tlbtlbtlb/scooter/sim/effgraph.png

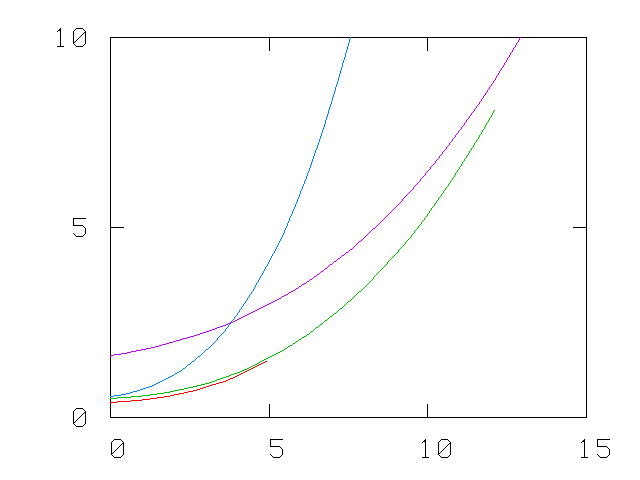
sim/effgraph.png
