tlbtlbtlb/scooter/sim/motor_torque_limits.png

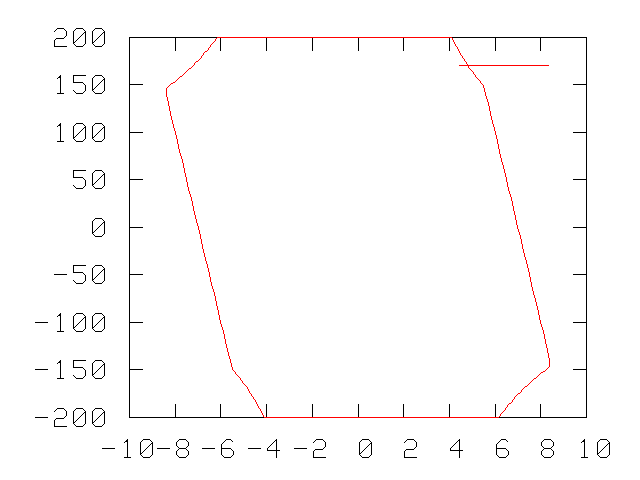
sim/motor_torque_limits.png
