tlbtlbtlb/scooter/sim/scooter-cartoon-frame.png

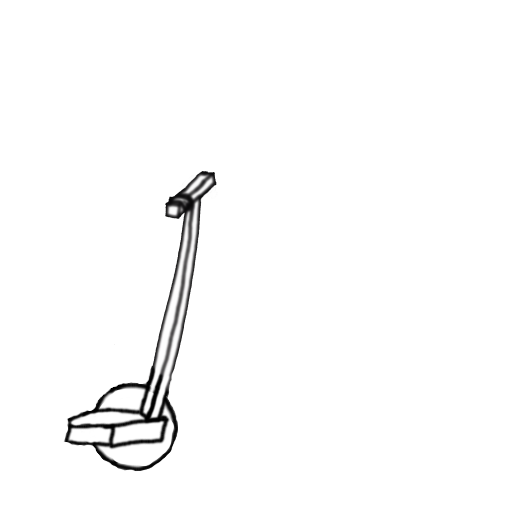
sim/scooter-cartoon-frame.png
