tlbtlbtlb/scooter/sim/scooter-cartoon-lowerarm.png

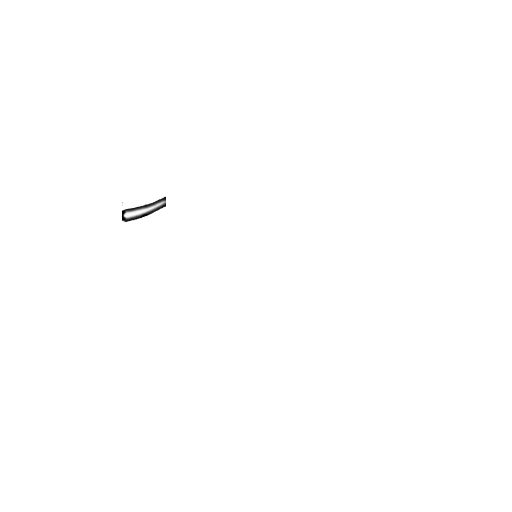
sim/scooter-cartoon-lowerarm.png
