tlbtlbtlb/scooter/sim/scooter-cartoon-ouch.png

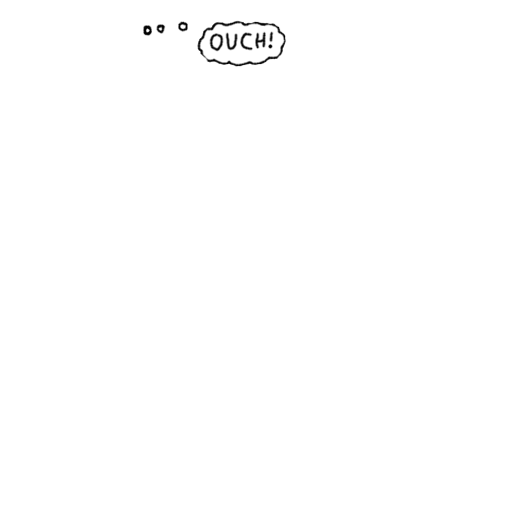
sim/scooter-cartoon-ouch.png
