tlbtlbtlb/scooter/sim/scooter-cartoon-rider.png

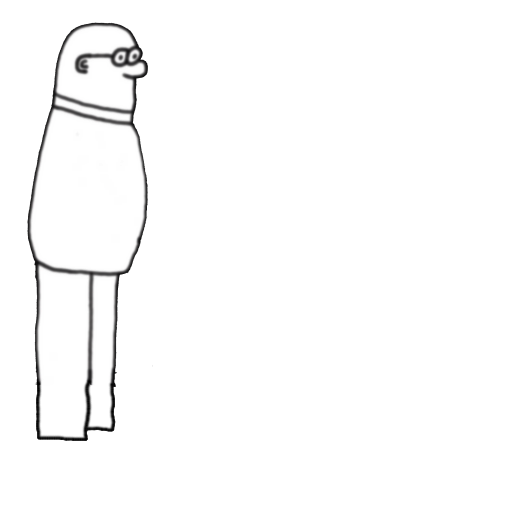
sim/scooter-cartoon-rider.png
