tlbtlbtlb/scooter/sim/scooter-cartoon-wheel.png

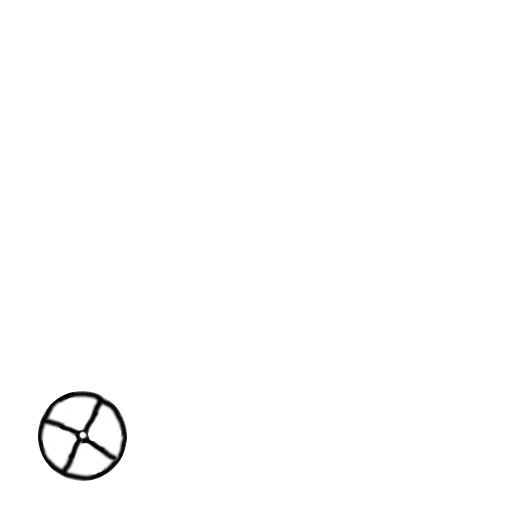
sim/scooter-cartoon-wheel.png
