tlbtlbtlb/scooter/sim/Slide1.png

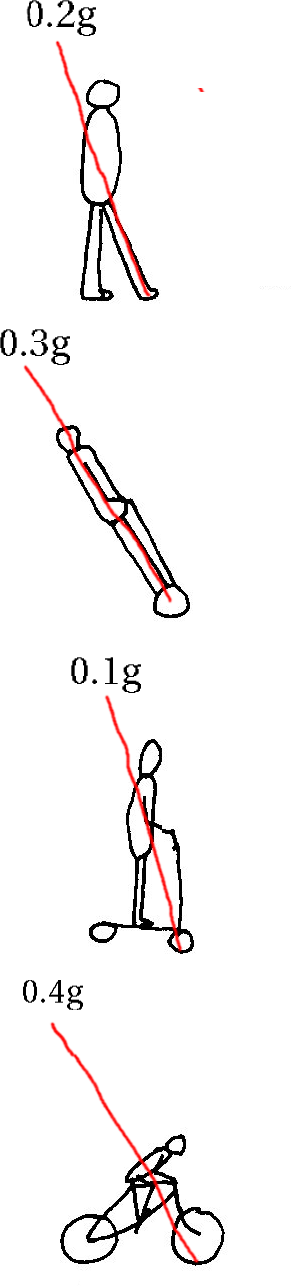
sim/Slide1.png
