tlbtlbtlb/scooter/sim/Slide2.png

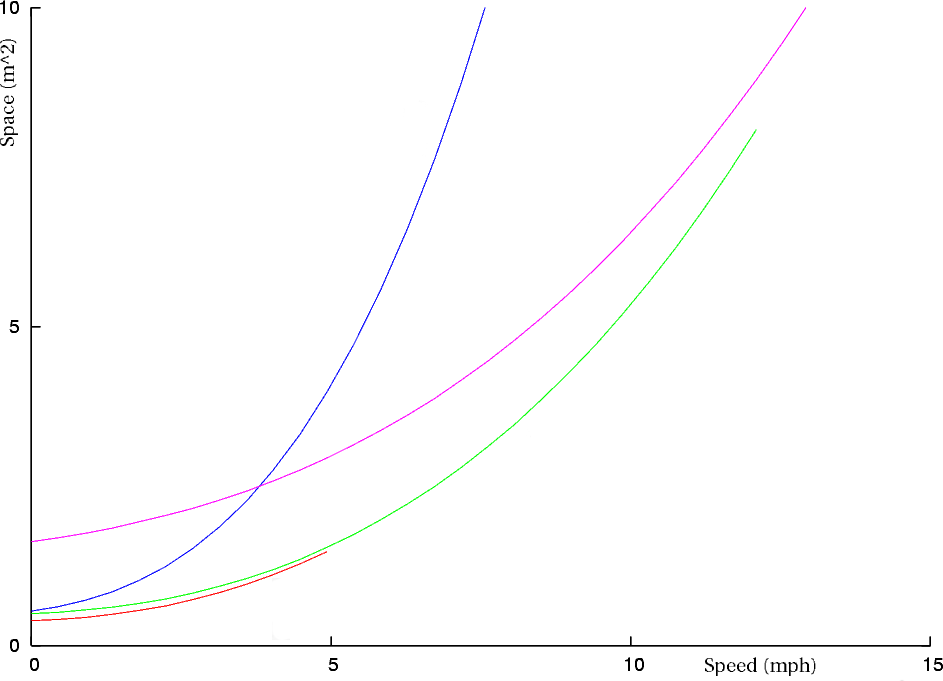
sim/Slide2.png
