tlbtlbtlb/scooter/sim/Slide3.png

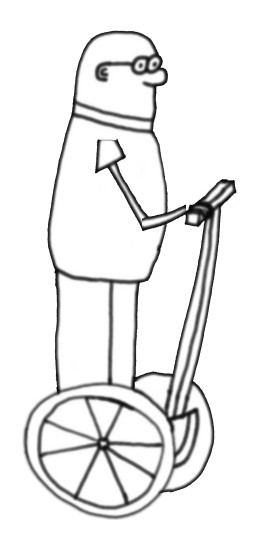
sim/Slide3.png
