tlbtlbtlb/scooter/sim/Slide5.png

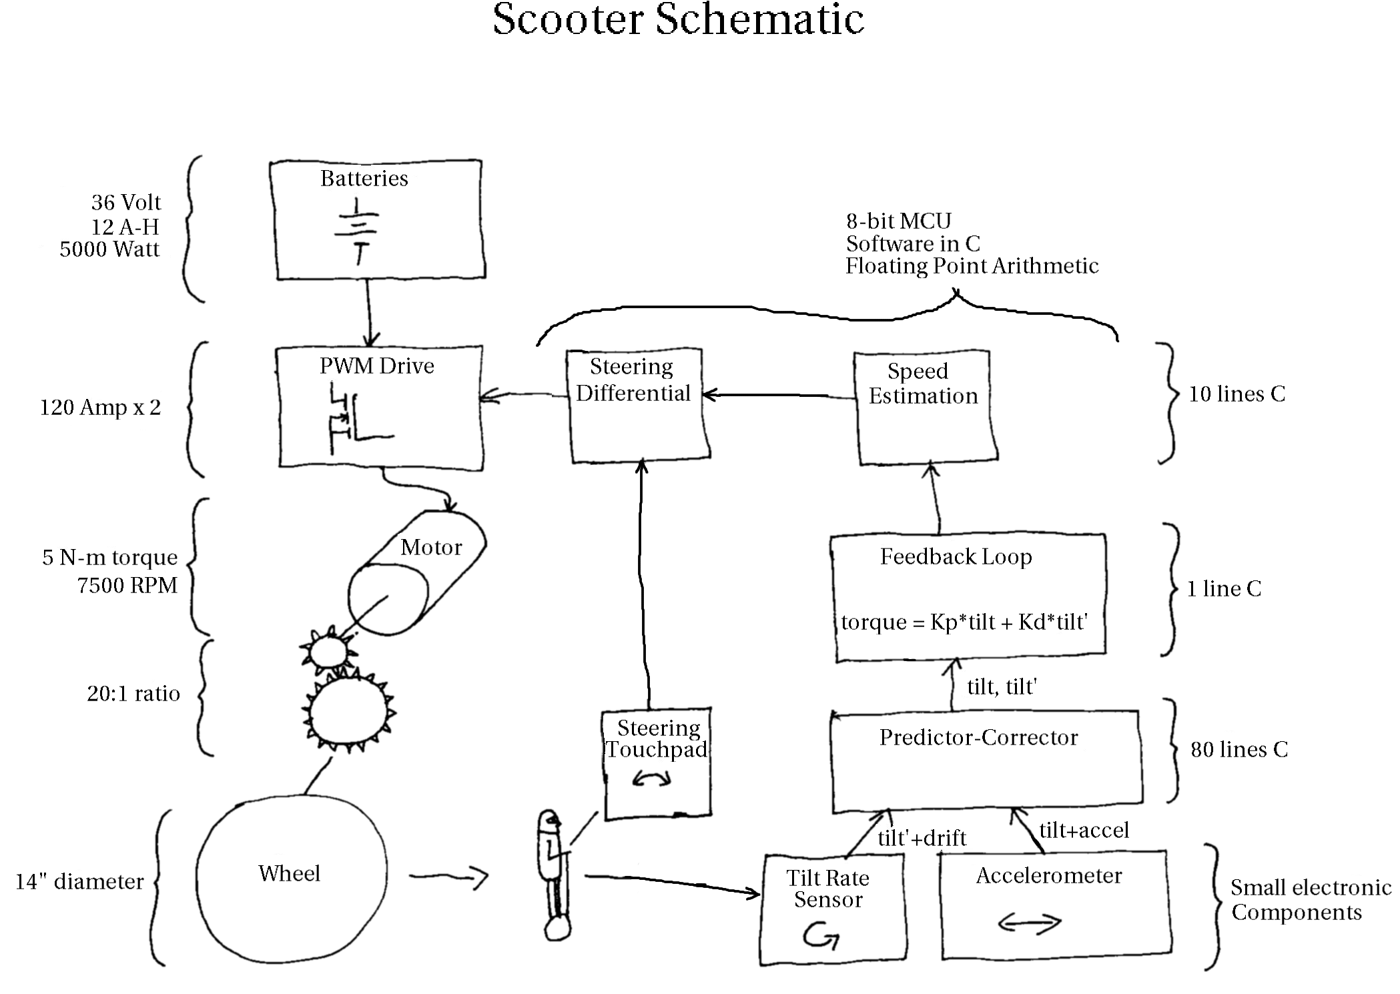
sim/Slide5.png
