tlbtlbtlb/scooter/sim/TopView.png

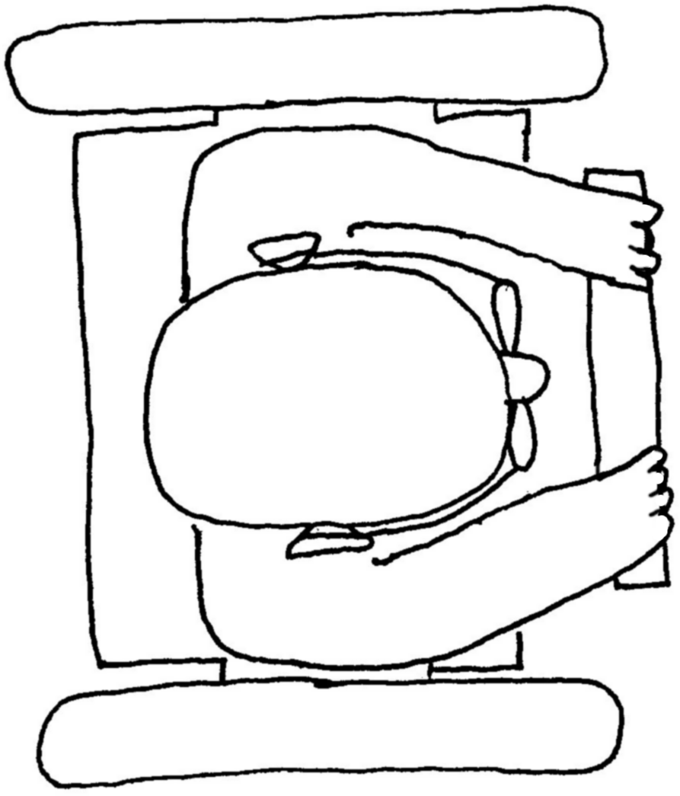
sim/TopView.png
