tlbtlbtlb/scooter/Unicycle/Mannequin.SLDASM

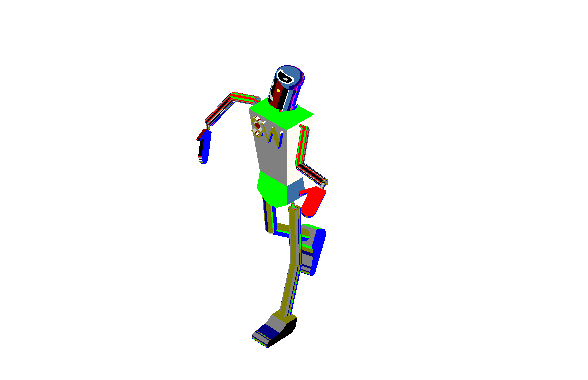
[picture p18: CAD file, 2012-12-04]
Unicycle/Mannequin.SLDASM
torso
head
arm x 4
leg x 4
foot x 2
hand x 2
