tlbtlbtlb/scooter/Unicycle/Unicycle.SLDASM

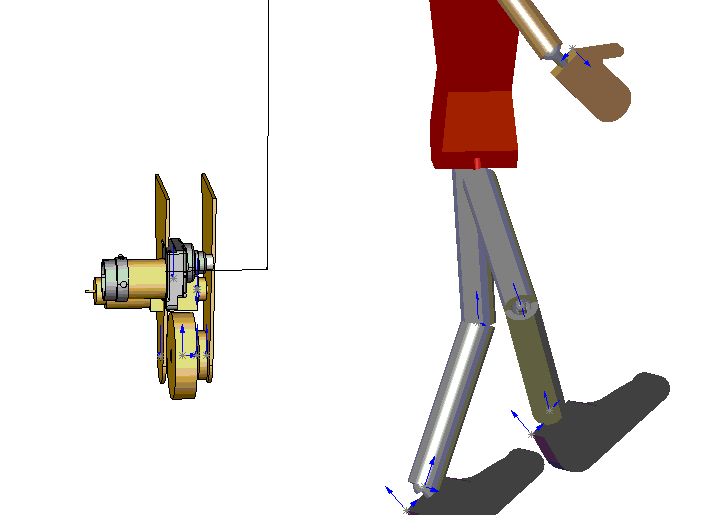
[picture p19: CAD file, 2012-12-04]
Unicycle/Unicycle.SLDASM
Right Side Plate
5mm HTD 15mm 72 teeth
Colson WC22
Left Side Plate
5mm HTD 15mm 34 teeth
S9134A-PG010SP
NPC_64038
torso
head
arm x 4
leg x 4
hand x 2
foot x 2
