tlbtlbtlb/scooter/Scooter Mechanical/Unicycle 2.SLDASM

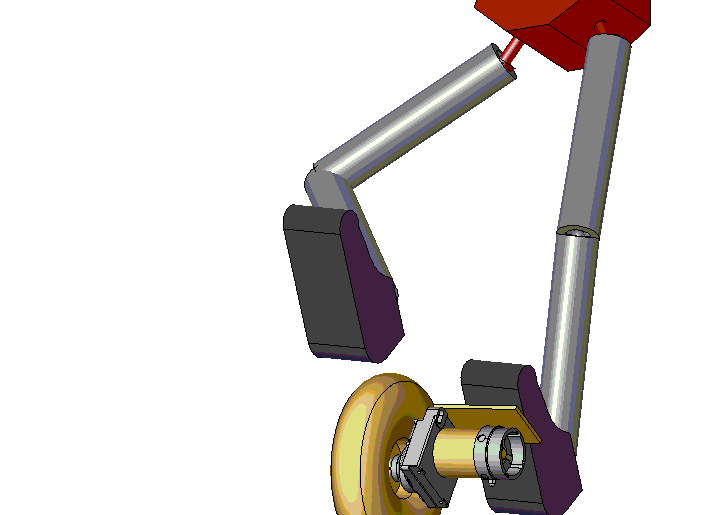
[picture p20: CAD file, 2012-12-04]
Scooter Mechanical/Unicycle 2.SLDASM
NPC_64038
NPC Wheel 14
torso
head
arm x 4
leg x 4
hand x 2
foot x 2
Top Plate
