tlbtlbtlb/scooter/Unicycle/Unicycle 7.SLDASM

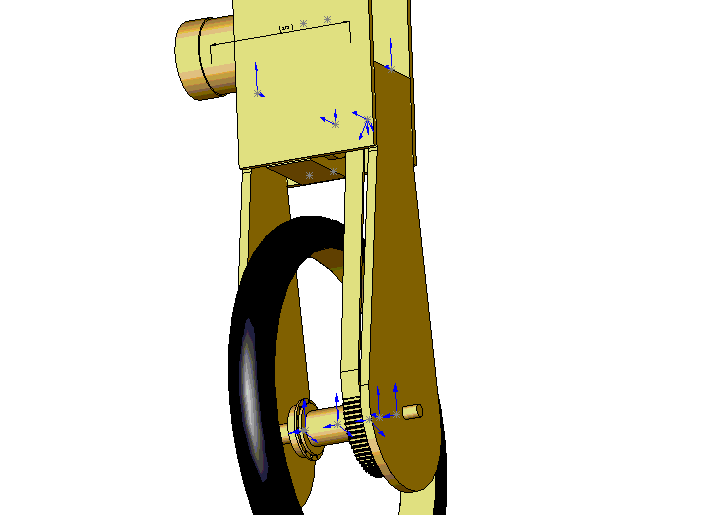
[picture p21: CAD file, 2012-12-04]
Unicycle/Unicycle 7.SLDASM
Front Plate
Side Bar x 2
Rear Plate
Belt Path
Instrument Ball Bearing_AI x 2
a_6a55_072nf1516_modified
Spoked Wheel Hub
Hub Axle
Hub Right Spacer 2
Hub Left Spacer 2
16 inch tire
Whyachi TWM3M
a_6a55_028df1516_modified
