tlbtlbtlb/scooter/Scooter Mechanical/Mannequin.SLDASM

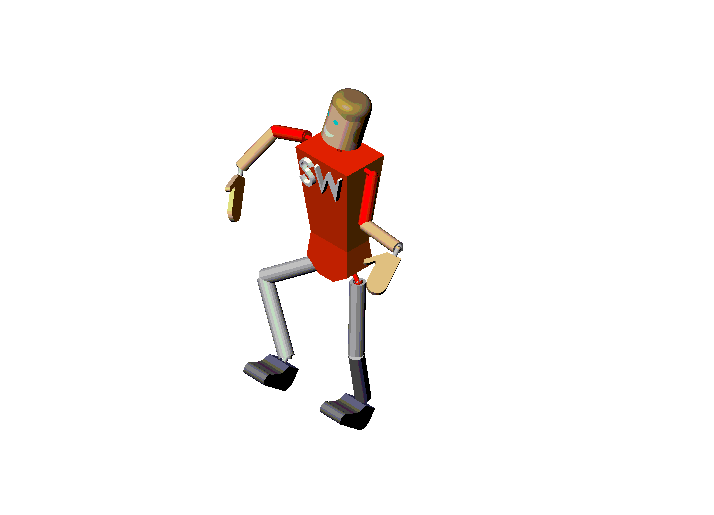
[picture p22: CAD file, 2012-12-04]
Scooter Mechanical/Mannequin.SLDASM
torso
head
arm x 4
leg x 4
hand x 2
foot x 2
