tlbtlbtlb/scooter/Unicycle/Unicycle 5.SLDASM

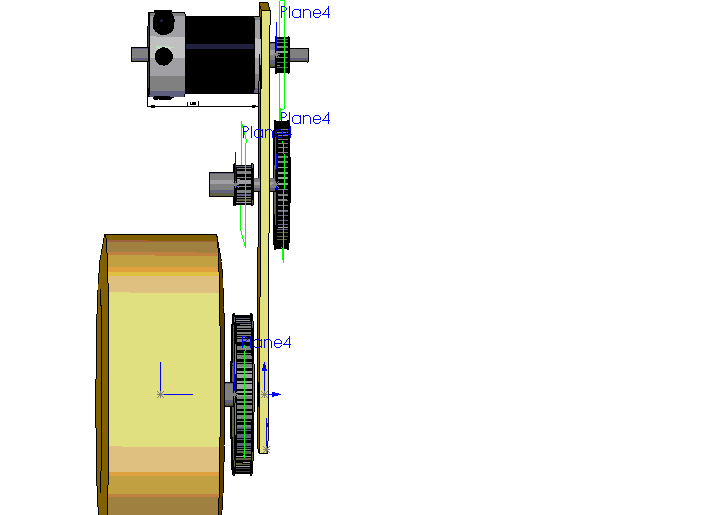
[picture p23: CAD file, 2012-12-04]
Unicycle/Unicycle 5.SLDASM
Timing Belt Pulley_AI x 4
Side Plate
Instrument Ball Bearing_AI
Magmotor S28-150
Go Kart Wheel
