tlbtlbtlb/scooter/Unicycle/Unicycle 3.SLDASM

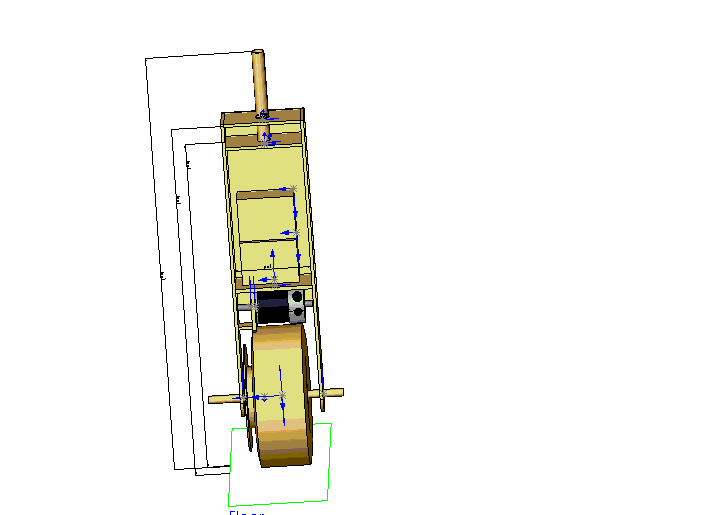
[picture p24: CAD file, 2012-12-04]
Unicycle/Unicycle 3.SLDASM
Go Kart Wheel
Wheel Shaft
Magmotor S28-150
Wheel Gear
Top Plate 2
Right Side Plate 2 x 2
Battlepack x 2
Motor Plate
Cover Plate
Top Plate 3 x 2
Seat Pipe
bead2
Motor Plate Brace
