tlbtlbtlb/scooter/Unicycle/Unicycle 4.SLDASM

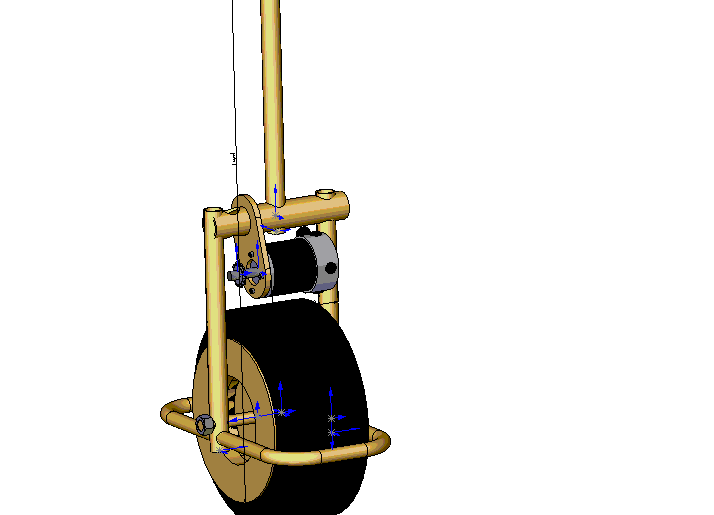
[picture p25: CAD file, 2012-12-04]
Unicycle/Unicycle 4.SLDASM
Go Kart Wheel
Wheel Gear
Magmotor S28-150
Side Pipe x 2
Wheel Shaft 2
Top Pipe
Motor Mount
Seat Pipe 2
Socket Head Cap Screw_AI x 4
Hex Nut_AI x 2
Hoop 2 x 2
Precision Roller Chain Sprocket_AI
