tlbtlbtlb/scooter/Unicycle/Electronics Box.SLDASM

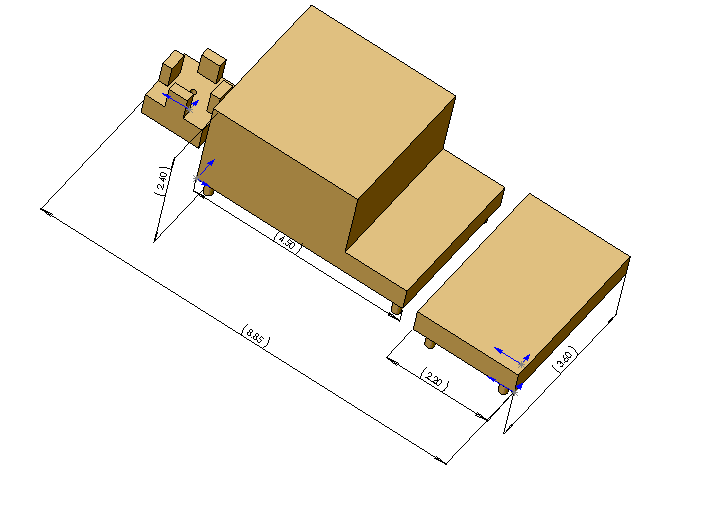
[picture p26: CAD file, 2012-12-04]
Unicycle/Electronics Box.SLDASM
Mavric II Outline
OSMC Outline
Bridge Rectifier Outline
