tlbtlbtlb/scooter/(list of files, cad)

Other CAD files:
Scooter Mechanical/Scooter.SLDASM
Scooter Mechanical/Skateboard.SLDASM
Scooter Mechanical/30 cell NiMH pack.sldasm
Scooter Mechanical/E7MS.SLDASM
Unicycle/Whyachi Motor and Pulley.SLDASM
Scooter Mechanical/Handlebars.SLDASM
Unicycle/Unicycle 6.SLDASM
Unicycle/Wheel and Pulley.sldasm
Scooter Mechanical/Motor Top Bar Left.SLDPRT
Unicycle/Top Plate.SLDPRT
Scooter Mechanical/NPC Wheel 14.SLDPRT
Scooter Mechanical/leg.SLDPRT
Scooter Mechanical/Dashboard.SLDPRT
Unicycle/Top Pipe.SLDPRT
Scooter Mechanical/Torque Sensor Mount.SLDPRT
Unicycle/Hub Axle.SLDPRT
Scooter Mechanical/6 cell NiMH pack.SLDPRT
Unicycle/Mavric II Outline.SLDPRT
Scooter Mechanical/Scooter Electronics Plate.SLDPRT
Unicycle/Yoke.SLDPRT
Scooter Mechanical/TRT-500.SLDPRT
Unicycle/Side Pipe 2.sldprt
Scooter Mechanical/Back Horiz Brace.SLDPRT
Unicycle/Wheel Gear.SLDPRT
Scooter Mechanical/Front Horiz Brace.SLDPRT
Unicycle/Hub Right Spacer 2.SLDPRT
Unicycle/Belt Guard.SLDPRT
Unicycle/arbeiter.sldprt
Scooter Mechanical/Bottom Plate.SLDPRT
Unicycle/a_6a55_028df1516_modified.SLDPRT
Scooter Mechanical/Battery Pack.SLDPRT
Unicycle/Hoop 2.SLDPRT
Unicycle/Colson WC22.SLDPRT
Scooter Mechanical/NPC 64038 Hub.SLDPRT
Unicycle/Front Plate 2.SLDPRT
Scooter Mechanical/Scooter Top Plate 2.SLDPRT
Unicycle/NPC PT-318.SLDPRT
Scooter Mechanical/Scooter Side Plate.SLDPRT
Unicycle/Magmotor S400.sldprt
Scooter Mechanical/Driver Heat Plate.SLDPRT
Unicycle/Go Kart Wheel.SLDPRT
Scooter Mechanical/Spoked Wheel Hub Large.SLDPRT
Unicycle/Spoked Wheel Hub.SLDPRT
Scooter Mechanical/arm.SLDPRT
Unicycle/Motor Mount.SLDPRT
Scooter Mechanical/Handle Top.SLDPRT
Unicycle/a_6a55_028df1516.SLDPRT
Scooter Mechanical/Scooter Handle Angle.SLDPRT
Unicycle/Side Bar.SLDPRT
Scooter Mechanical/TD132 Load Cell.SLDPRT
Unicycle/Top Pipe 2.SLDPRT
Scooter Mechanical/Bottom Plate 2.SLDPRT
Scooter Mechanical/Front Top Brace.SLDPRT
Unicycle/a_6a55_072nf1516.SLDPRT
Scooter Mechanical/Handlebar Grip.SLDPRT
Unicycle/Magmotor Bracket.SLDPRT
Scooter Mechanical/Scooter Bottom Bar Rear.SLDPRT
Unicycle/Seat Pipe 3.SLDPRT
Scooter Mechanical/Roboteq AX2500.SLDPRT
Unicycle/Front Plate.SLDPRT
Scooter Mechanical/SB Front Bottom Brace.SLDPRT
Unicycle/Hoop 1.SLDPRT
Unicycle/15 inch tire.SLDPRT
Scooter Mechanical/hand.SLDPRT
Unicycle/Footpeg.SLDPRT
Scooter Mechanical/Scooter Handle.SLDPRT
Unicycle/Whyachi Bracket.SLDPRT
Scooter Mechanical/Front Bottom Brace.SLDPRT
Unicycle/Bridge Rectifier Outline.SLDPRT
Scooter Mechanical/Scooter Motor Bottom Ext.SLDPRT
Unicycle/Browing 5ARA1-LR10.SLDPRT
Scooter Mechanical/Scooter Bottom Plate.SLDPRT
Unicycle/S9134A-PG010SP.SLDPRT
Scooter Mechanical/NPC_64038.SLDPRT
Unicycle/Cover Plate.SLDPRT
Scooter Mechanical/Scooter Top Plate.SLDPRT
Unicycle/16 inch tire.SLDPRT
Scooter Mechanical/SB Top Plate.SLDPRT
Unicycle/20 inch tire.SLDPRT
Scooter Mechanical/Handle Pipe.SLDPRT
Unicycle/Hub Right Spacer.SLDPRT
Scooter Mechanical/Skateboard Side Bar.SLDPRT
Scooter Mechanical/torso.SLDPRT
Unicycle/bead2.sldprt
Scooter Mechanical/foot.SLDPRT
Unicycle/leg.SLDPRT
Scooter Mechanical/Rear Edge Brace.SLDPRT
Scooter Mechanical/Rear Horiz Brace.SLDPRT
Unicycle/Side Axle Holder.SLDPRT
Scooter Mechanical/Front Edge Brace.SLDPRT
Unicycle/a_6a55_072nf1516_modified.SLDPRT
Scooter Mechanical/Top Structure.SLDPRT
Unicycle/Footrest.SLDPRT
Scooter Mechanical/Scooter Shroud 2.SLDPRT
Scooter Mechanical/head.SLDPRT
Unicycle/5mm HTD 15mm 34 teeth.SLDPRT
Scooter Mechanical/Side Plate.SLDPRT
Unicycle/Seat Pipe.SLDPRT
Scooter Mechanical/Scooter Bottom Bar Front.SLDPRT
Unicycle/foot.SLDPRT
Unicycle/Side Pipe.sldprt
Unicycle/Wheel Shaft.SLDPRT
Unicycle/Top Plate 3.SLDPRT
Unicycle/Unicycle Housing.SLDPRT
Unicycle/Right Side Plate.SLDPRT
Unicycle/Right Side Plate 2.SLDPRT
Unicycle/Rear Plate.SLDPRT
Unicycle/Battery Shelf.SLDPRT
Unicycle/Belt Path.SLDPRT
Unicycle/5mm HTD 15mm 72 teeth.SLDPRT
Unicycle/Left Side Plate.SLDPRT
Unicycle/Side Plate.SLDPRT
Unicycle/Motor Plate.SLDPRT
Unicycle/Part13.sldprt
Unicycle/head.SLDPRT
Unicycle/Hub Left Spacer.SLDPRT
Unicycle/Battlepack.SLDPRT
Unicycle/hand.SLDPRT
Unicycle/torso.SLDPRT
Unicycle/Motor Plate Brace.SLDPRT
Unicycle/Wheel Shaft 2.SLDPRT
Unicycle/Top Plate 2.SLDPRT
Unicycle/arm.SLDPRT
Unicycle/Magmotor S28-150.sldprt
Unicycle/Axle Holder and Footrest.SLDPRT
Unicycle/Whyachi TWM3M.SLDPRT
Unicycle/Hub Left Spacer 2.SLDPRT
Unicycle/Seat Pipe 2.SLDPRT
Unicycle/bead1.sldprt
Unicycle/OSMC Outline.SLDPRT
Scooter Mechanical/Electronics Drawings.SLDDRW
Scooter Mechanical/Handlebars.SLDDRW
Scooter Mechanical/Scooter Drawings.SLDDRW
Scooter Mechanical/Skateboard Fab.SLDDRW
Unicycle/Unicycle 4.SLDDRW
Unicycle/Unicycle 6.SLDDRW
Unicycle/Unicycle.SLDDRW
Unicycle/Whyachi Bolt Plate 2.SLDPRT
Unicycle/Whyachi Bolt Plate.SLDPRT
Unicycle/a_6a55_028df1516.igs
Unicycle/a_6a55_072nf1516.igs
