tlbtlbtlb/scooter/Scooter Drawings.pdf

# Trevor Blac kwell tlb@tlb.org

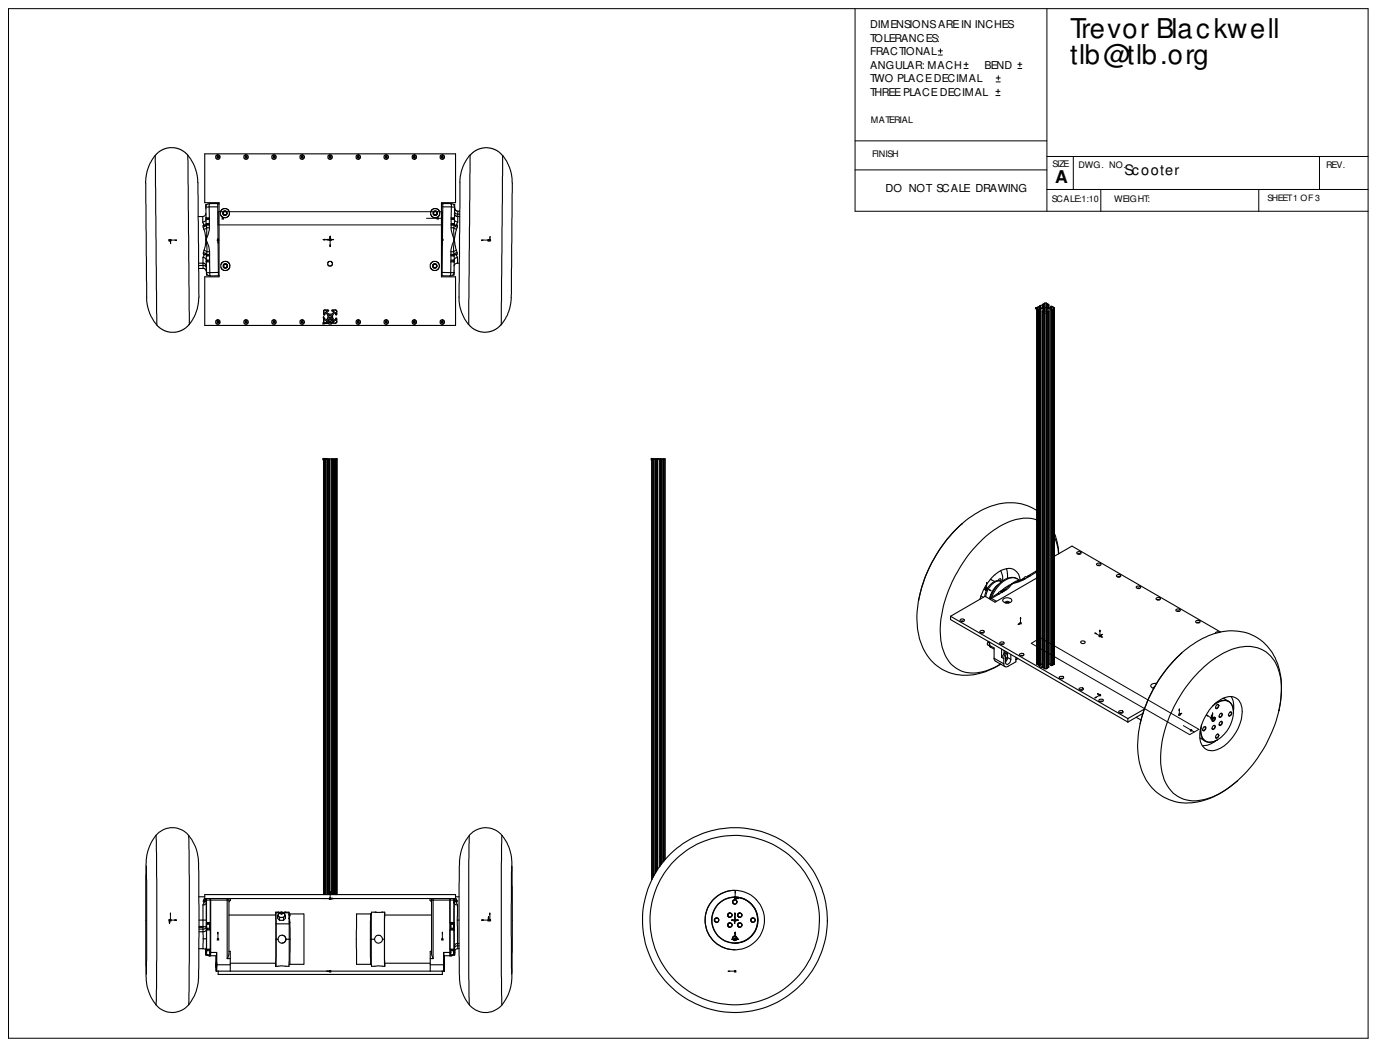
[picture p27: page 1]
MATERIAL; FINISH; ANGULAR: MACH; BEND

DIMENSIONSAREIN INCHES
TOLERANCES:
FRACTIONAL
TWO PLACE DECIMAL
THREEPLACE DECIMAL

SIZE A | DWG. NO. Sc ooter | REV.

DO NOT SCALE DRAWING

SCALE:1:10 | WEIGHT: | SHEET1 OF 3

0.656 X 82°

# 4 Holes

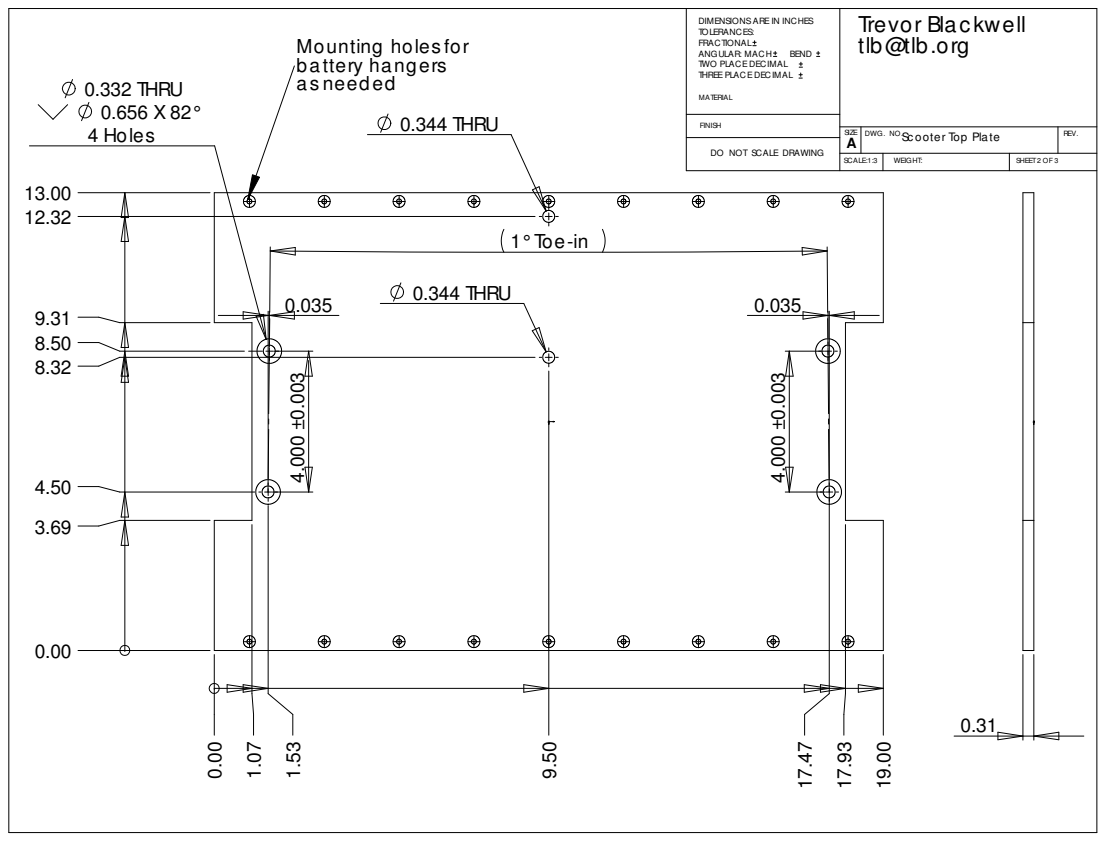
[picture p28: page 2]
0.332 THRU; 0.344 THRU; 0.344 THRU 0.035; 1°Toe-in; MATERIAL; FINISH; ANGULAR: MACH; BEND

Mounting holes for
battery hangers
a s needed

tlb@tlb.org

TWO PLACE DECIMAL
THREEPLACE DECIMAL

SIZE A | DWG. NO. Sc ooter Top Plate | REV.

DO NOT SCALE DRAWING

SCALE:1:3 | WEIGHT: | SHEET2 OF 3

# tlb@tlb.org

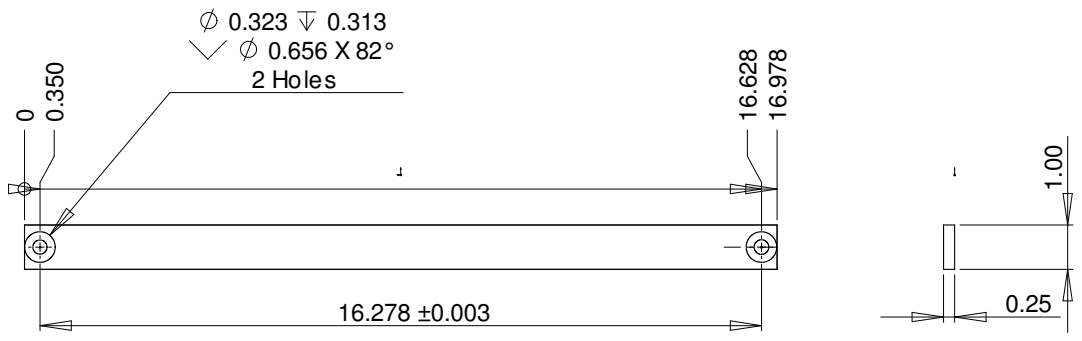
[picture p29: page 3]
0.656 X 82° 2 Holes; MATERIAL; FINISH; ANGULAR: MACH; BEND

TWO PLACE DECIMAL
THREEPLACE DECIMAL

SIZE A | DWG. NO. Sc ooter Bottom Bar Rear | REV.

DO NOT SCALE DRAWING

SCALE:1:3 | WEIGHT: | SHEET3 OF 3
