tlbtlbtlb/scooter/doc/pcb_all.pdf

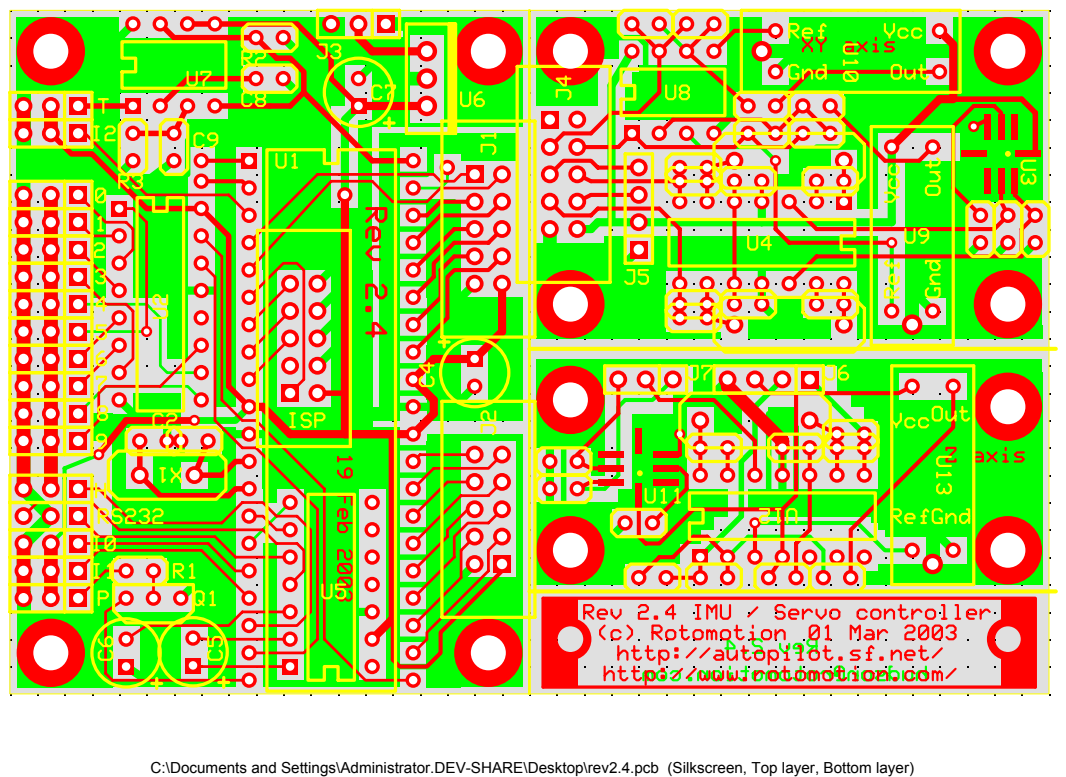
[picture p30: page 1]

C:\Documents and Settings\Administrator.DEV-SHARE\Desktop\rev2.4.pcb (Silkscreen, Top layer, Bottom layer)
