tlbtlbtlb/scooter/autopilot/onboard-release/pcb/rev2.pdf

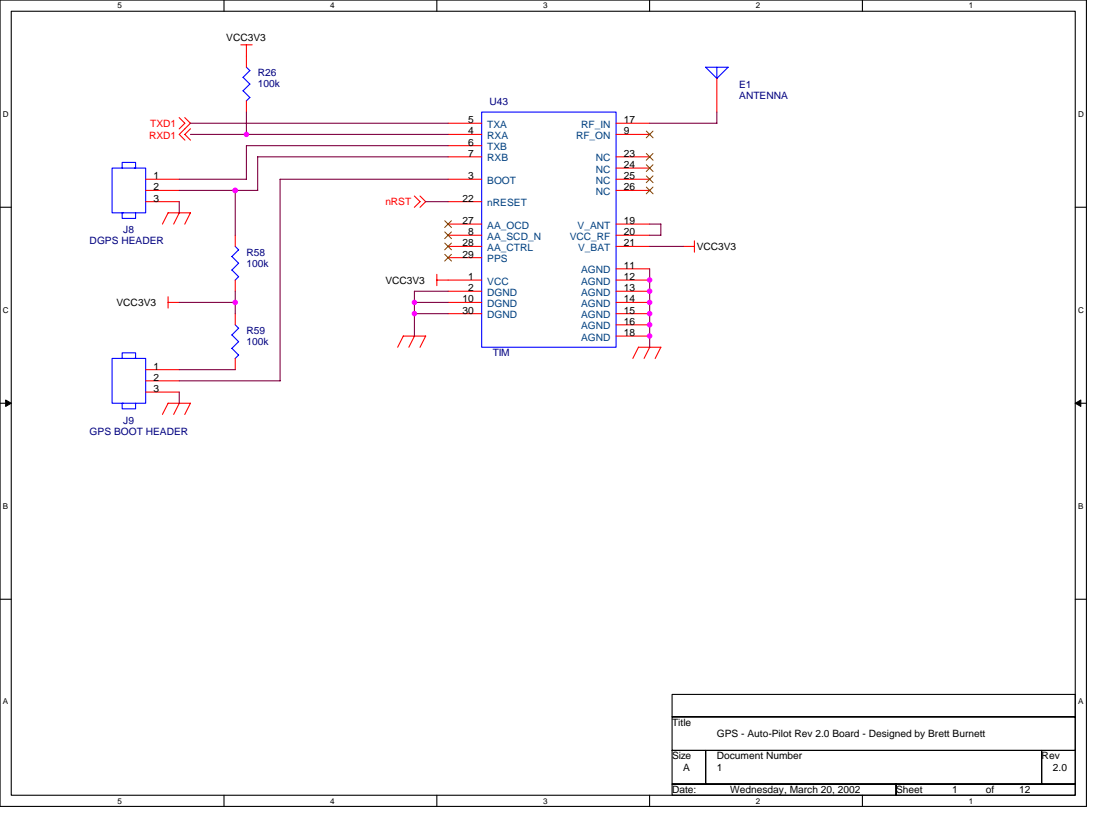
[picture p31: page 1]
Title; nRST; TXD1 RXD1; VCC3V3; TIM; TXA RXA TXB RXB; BOOT; nRESET; AA_OCD AA_SCD_N AA_CTRL PPS; VCC; V_ANT; V_BAT; VCC_RF; DGND DGND; AGND AGND AGND AGND AGND AGND AGND; DGND; ANTENNA; J8 DGPS HEADER

GPS BOOT HEADER

GPS - Auto-Pilot Rev 2.0 Board - Designed by Brett Burnett

Size A | Document Number 1 | Rev 2.0

Date: Wednesday, March 20, 2002 | Sheet 1 of 12

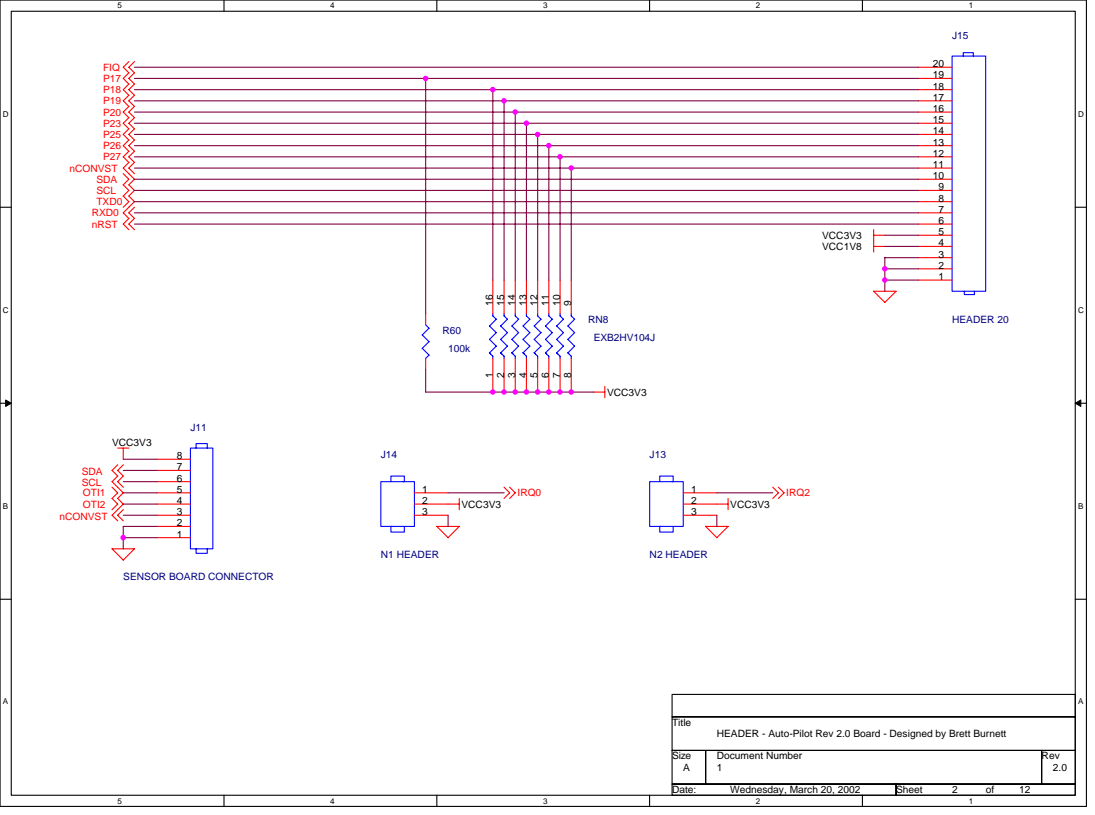
[picture p32: page 2]

HEADER - Auto-Pilot Rev 2.0 Board - Designed by Brett Burnett

Size A | Document Number 1 | Rev 2.0

Wednesday, March 20, 2002 | 2 12

# JTAG - 20 Pin ARM Connector

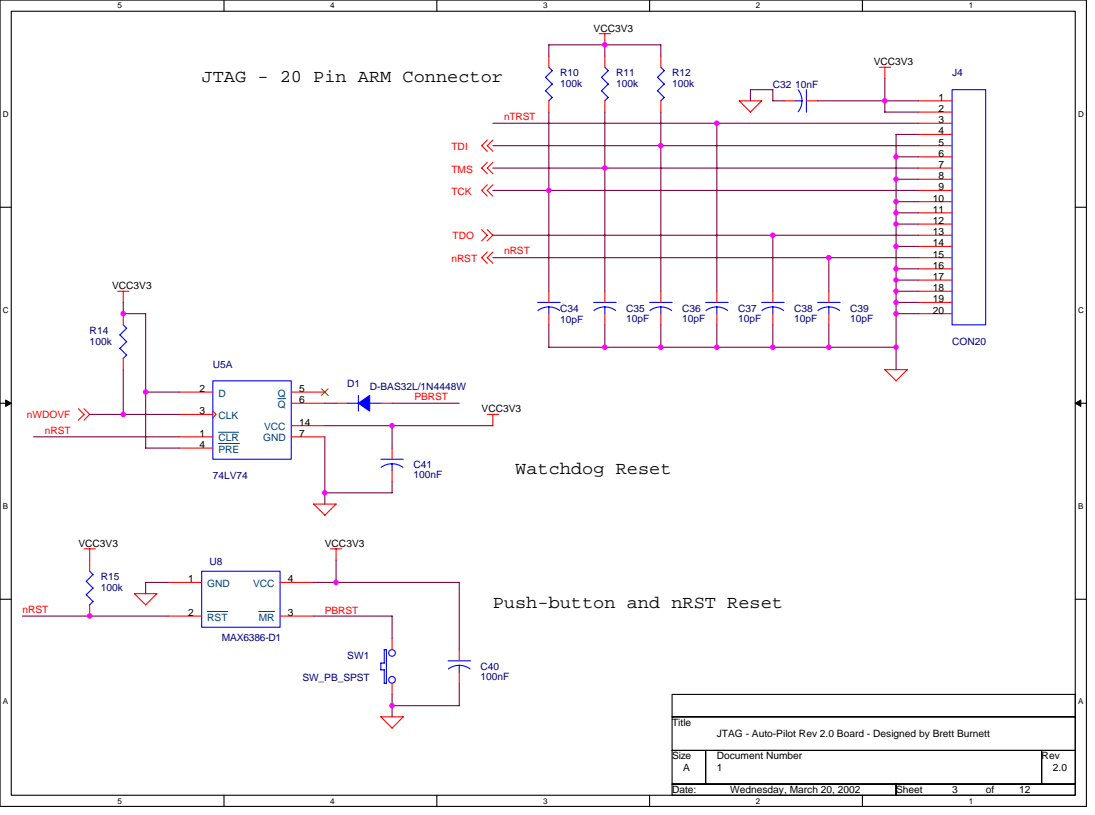
[picture p33: page 3]

Push-button and nRST Reset

JTAG - Auto-Pilot Rev 2.0 Board - Designed by Brett Burnett

Size A | Document Number 1 | Rev 2.0

Wednesday, March 20, 2002 | 3 12

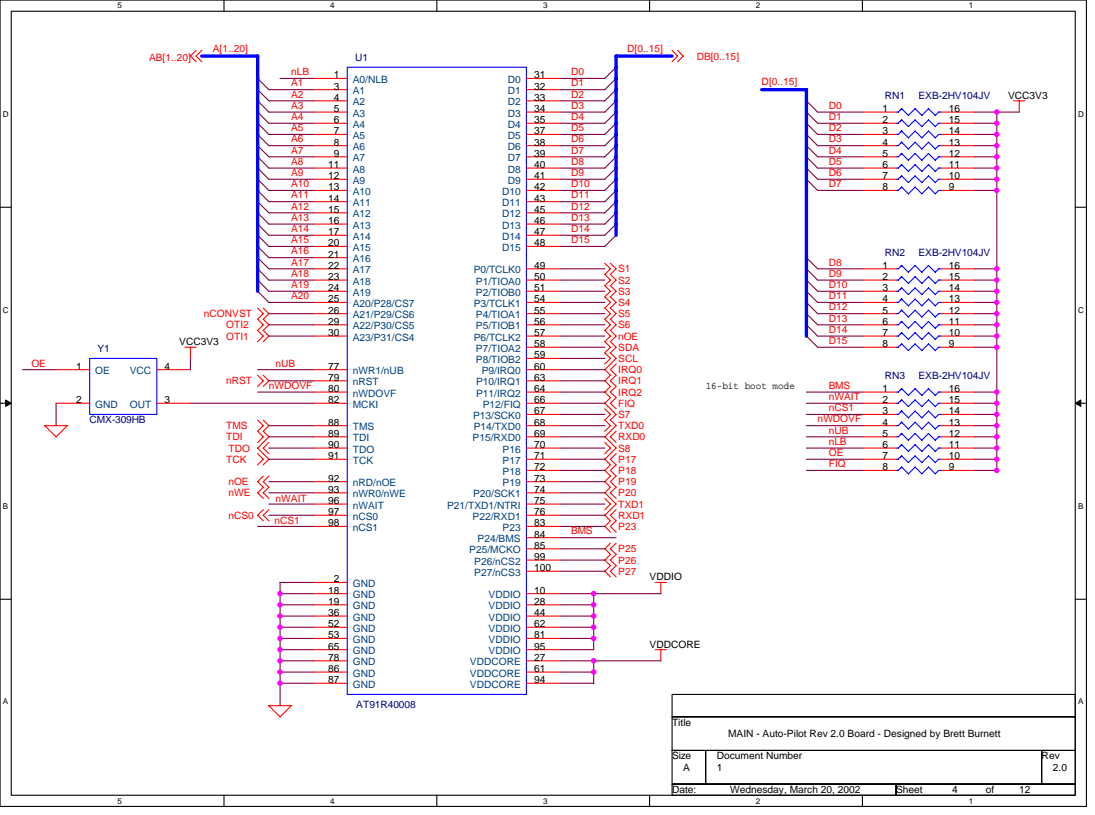
[picture p34: page 4]

MAIN - Auto-Pilot Rev 2.0 Board - Designed by Brett Burnett

Size A | Document Number 1 | Rev 2.0

Wednesday, March 20, 2002 | 4 12

# 512K I2C EEPROM

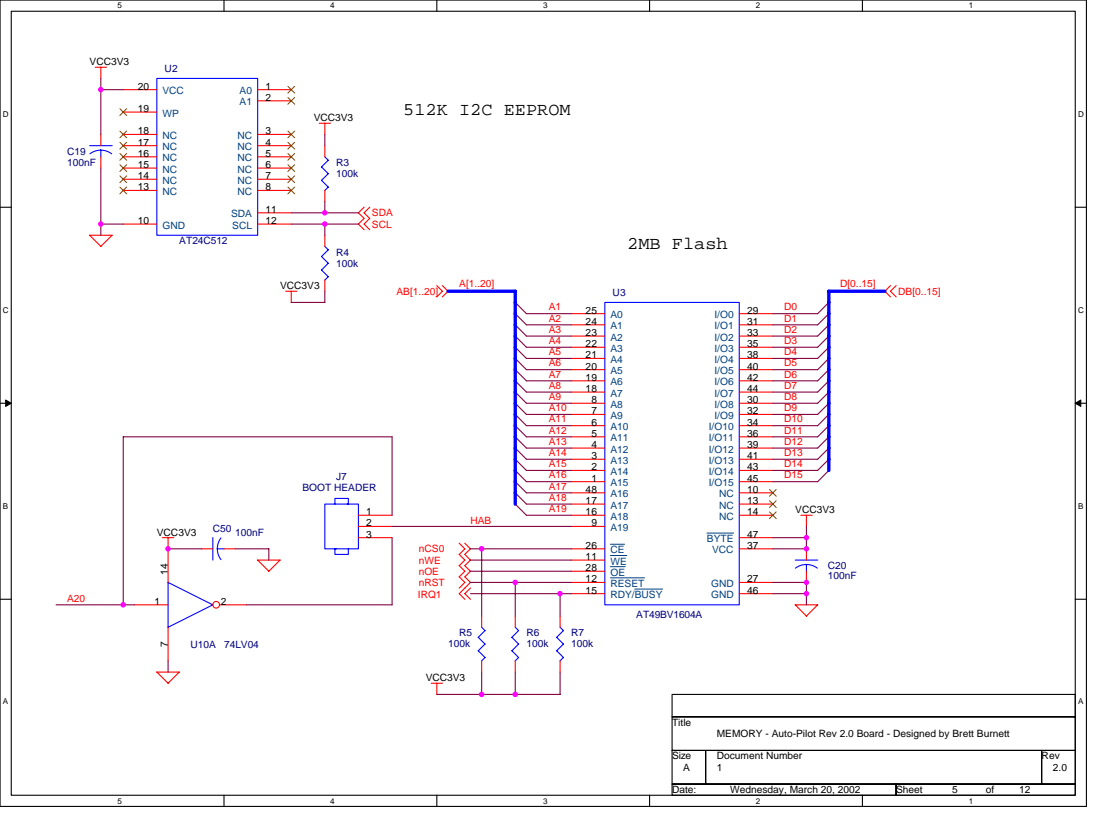
[picture p35: page 5]

MEMORY - Auto-Pilot Rev 2.0 Board - Designed by Brett Burnett

Size A | Document Number 1 | Rev 2.0

Wednesday, March 20, 2002 | 5 12

# Lithium Battery Charger

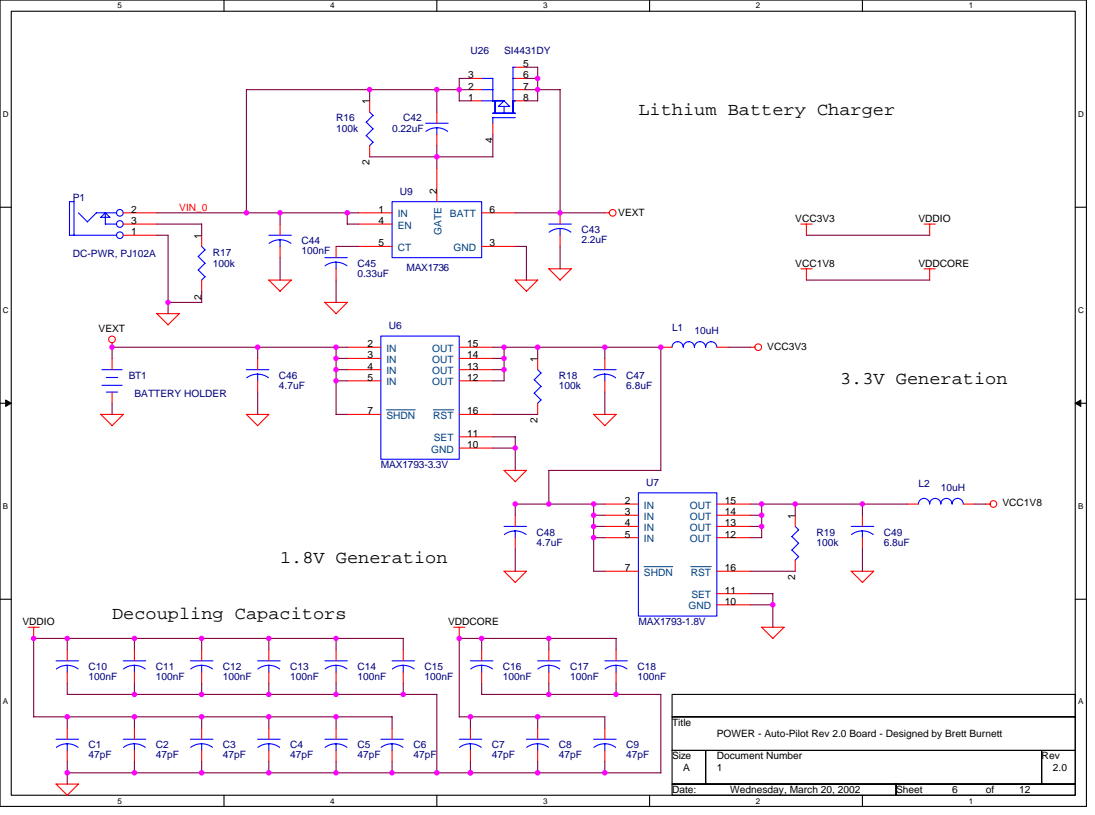
[picture p36: page 6]

POWER - Auto-Pilot Rev 2.0 Board - Designed by Brett Burnett

Size A | Document Number 1 | Rev 2.0

Wednesday, March 20, 2002 | 6 12

# UART RS-232 level Converter and Headers

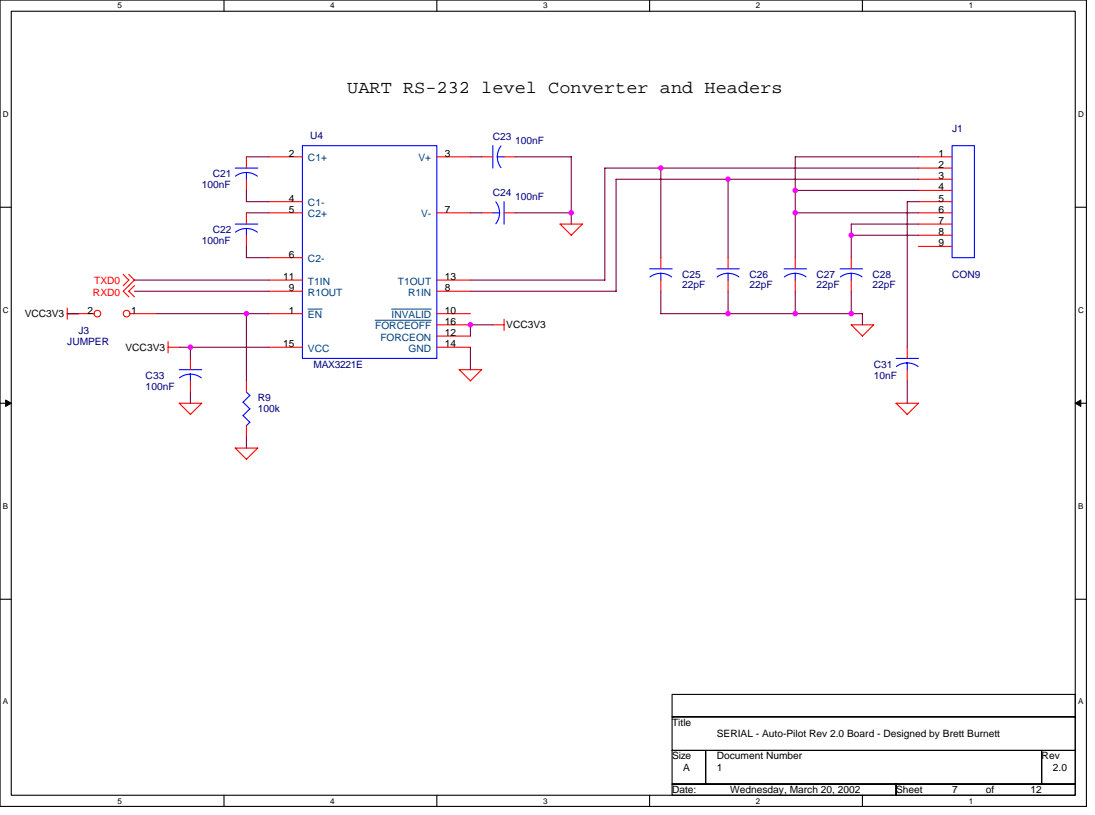
[picture p37: page 7]

SERIAL - Auto-Pilot Rev 2.0 Board - Designed by Brett Burnett

Size A | Document Number 1 | Rev 2.0

Wednesday, March 20, 2002 | 7 12

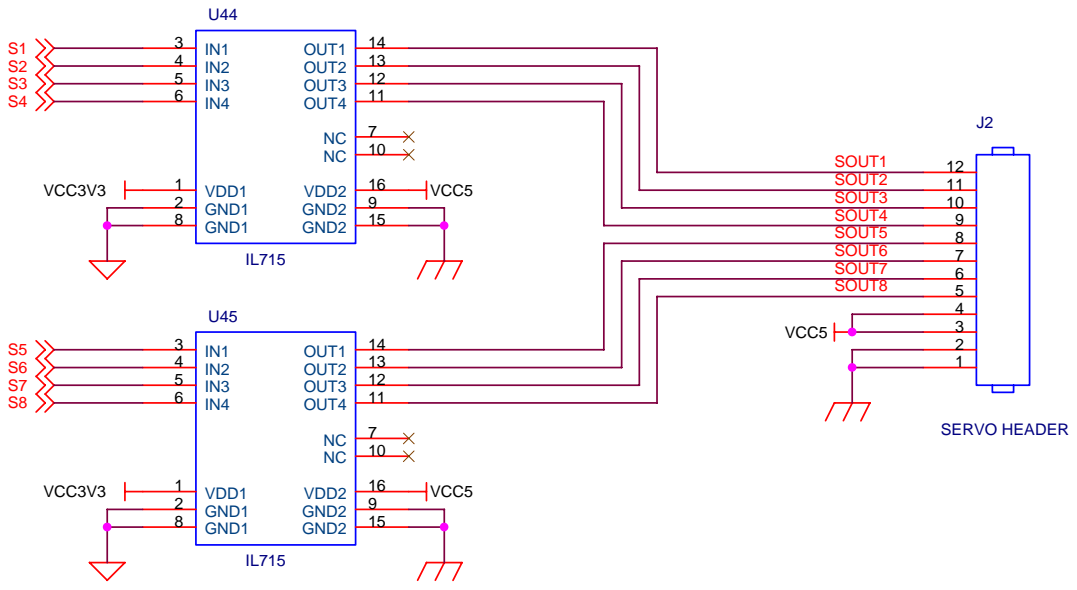
[picture p38: page 8]
Title; SOUT2; SOUT4; SOUT8; SOUT7; SOUT1; SOUT3; SOUT5 SOUT6; VCC5; VCC3V3; VDD1 GND1 GND1; VDD2 GND2 GND2; OUT1 OUT2 OUT3 OUT4; SERVO HEADER

SERVOS - Auto-Pilot Rev 2.0 Board - Designed by Brett Burnett

Size A | Document Number 1 | Rev 2.0

Wednesday, March 20, 2002 | 8 12

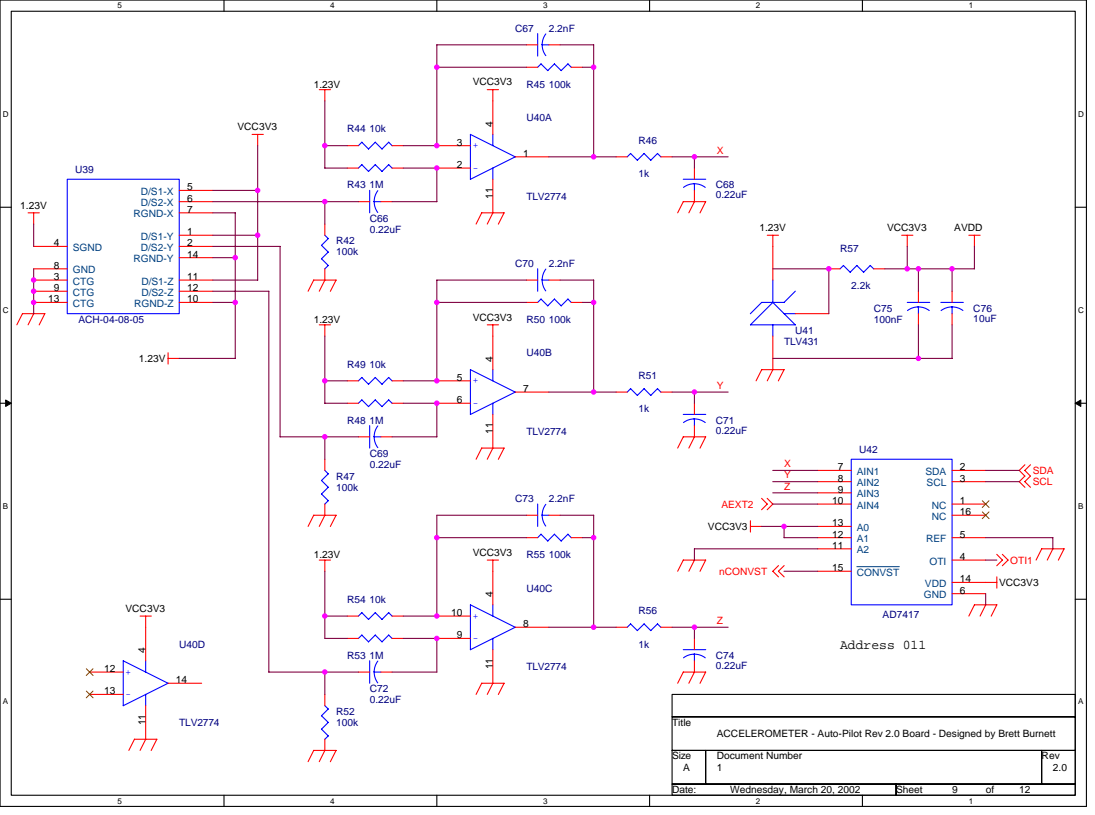
[picture p39: page 9]

ACCELEROMETER - Auto-Pilot Rev 2.0 Board - Designed by Brett Burnett

Size A | Document Number 1 | Rev 2.0

Wednesday, March 20, 2002 | 9 12

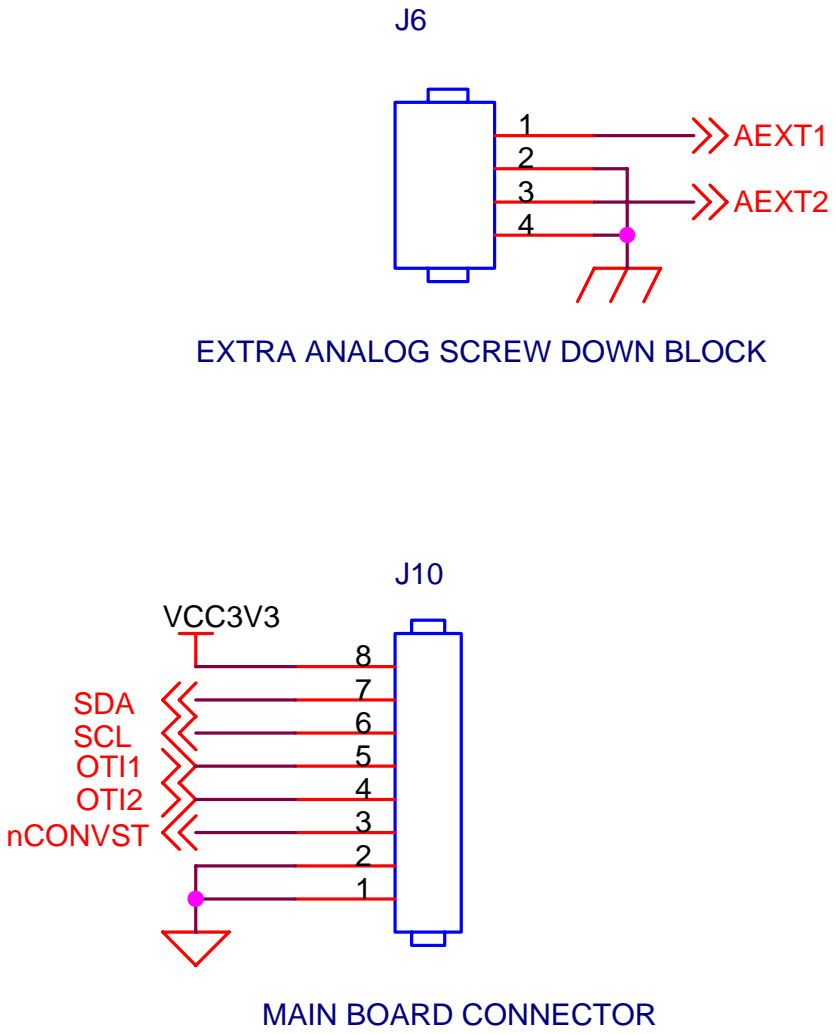
[picture p40: page 10]
SDA SCL OTI1 OTI2 nCONVST; AEXT2; AEXT1; VCC3V3

EXTRA ANALOG SCREW DOWN BLOCK

MAIN BOARD CONNECTOR

Title
DAUGHTER HEADERS - Auto-Pilot Rev 2.0 Board - Designed by Brett Burnett

Size A | Document Number 1 | Rev 2.0

Wednesday, March 20, 2002 | 10 12

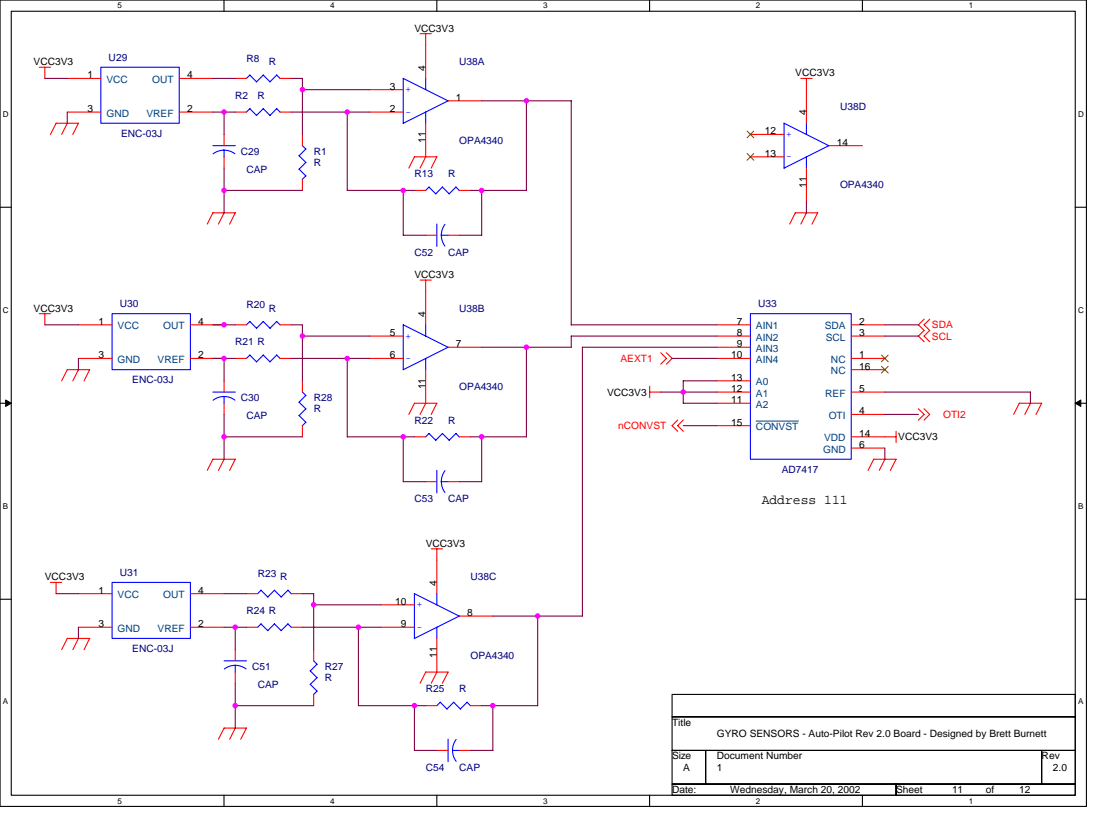
[picture p41: page 11]

GYRO SENSORS - Auto-Pilot Rev 2.0 Board - Designed by Brett Burnett

Size A | Document Number 1 | Rev 2.0

Wednesday, March 20, 2002 | 11 12

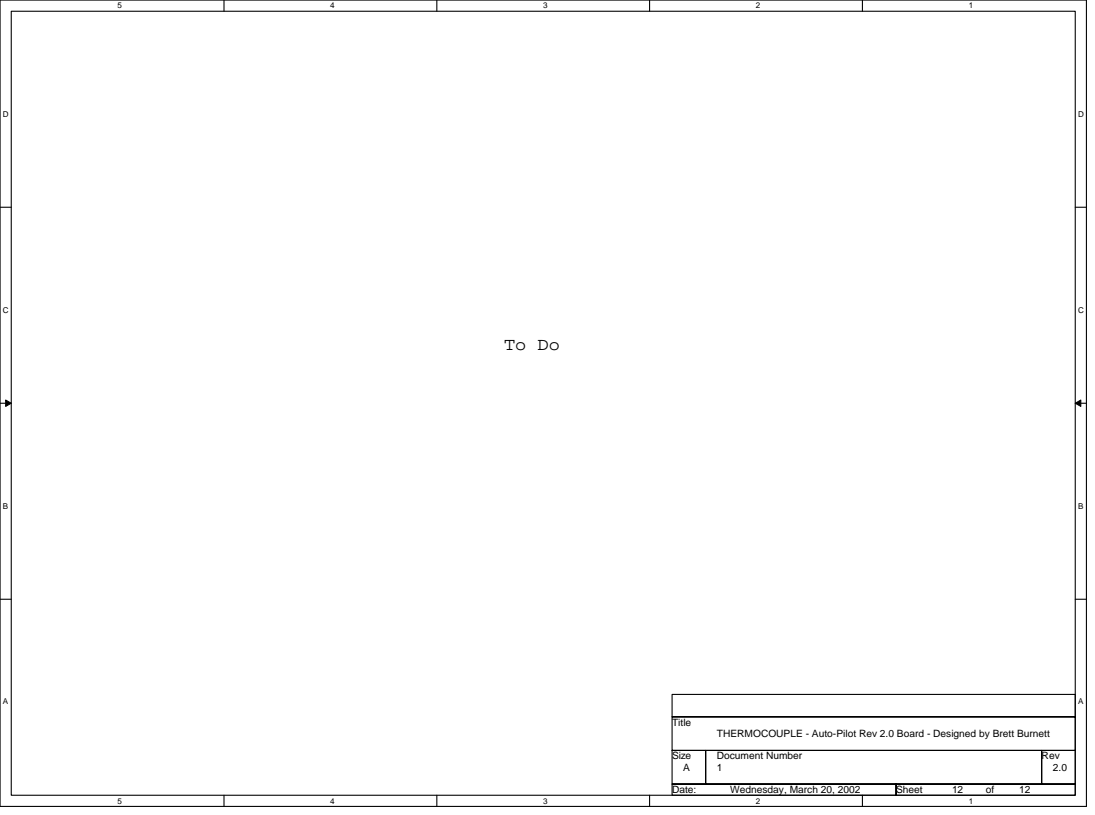
[picture p42: page 12]
Title

THERMOCOUPLE - Auto-Pilot Rev 2.0 Board - Designed by Brett Burnett

Size A | Document Number 1 | Rev 2.0

Wednesday, March 20, 2002 | 12 12
