tlbtlbtlb/scooter/electronics/controller6/stuffdraw.pdf

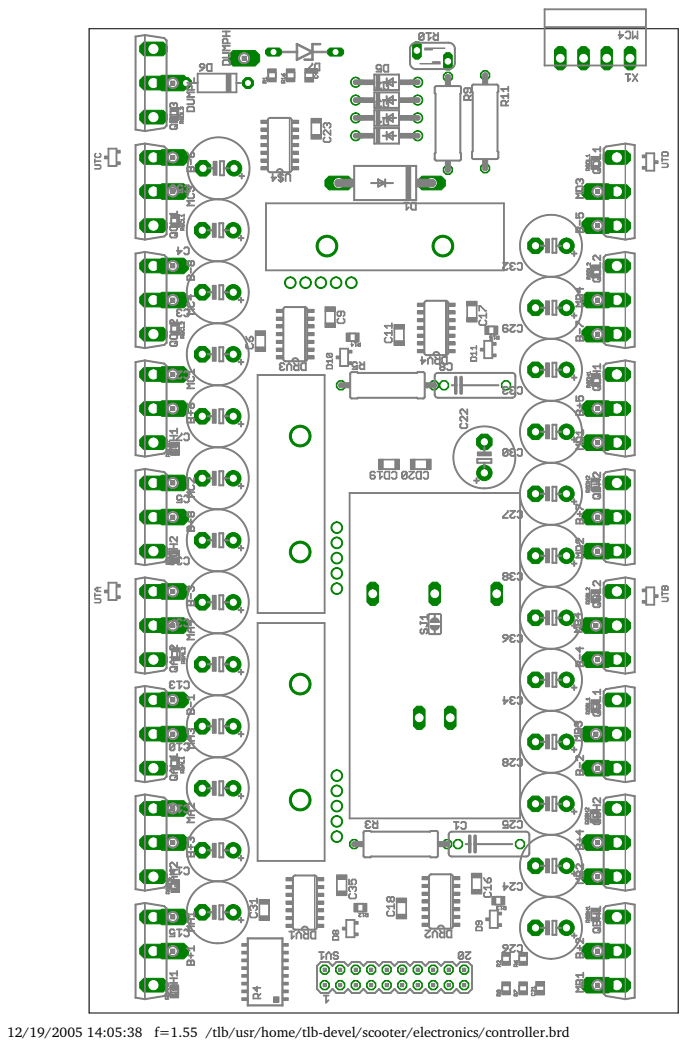
[picture p43: page 1]

12/19/2005 14:05:38 f=1.55 /tlb/usr/home/tlb-devel/scooter/electronics/controller.brd

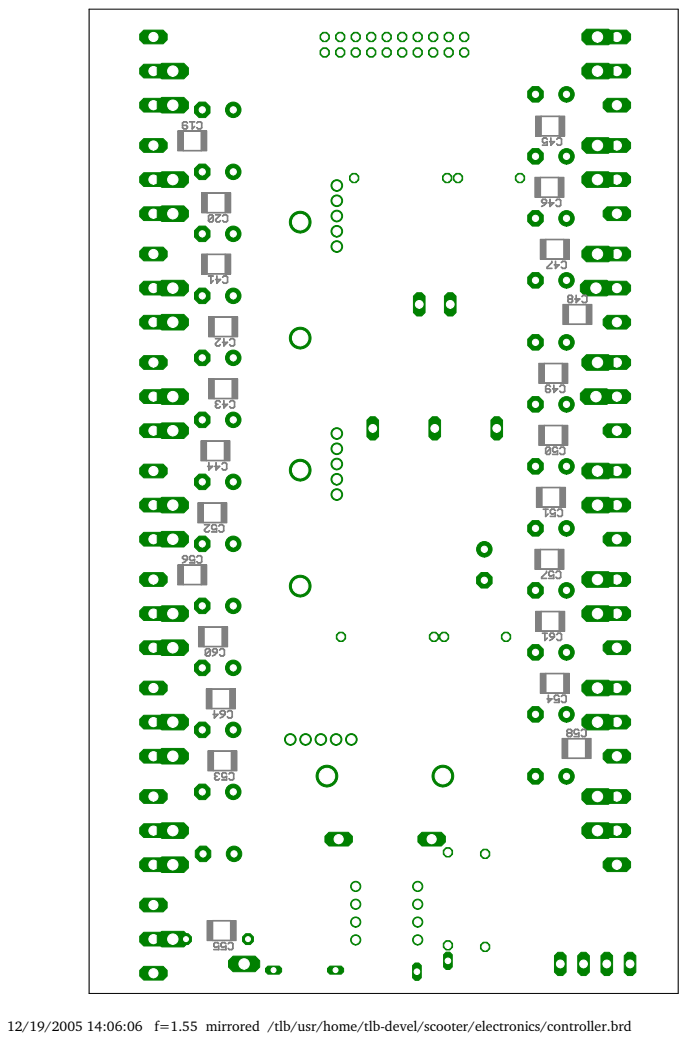
[picture p44: page 2]

12/19/2005 14:06:06 f=1.55 mirrored /tlb/usr/home/tlb-devel/scooter/electronics/controller.brd
