tlbtlbtlb/scooter/electronics/controller6/wiring.pdf

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

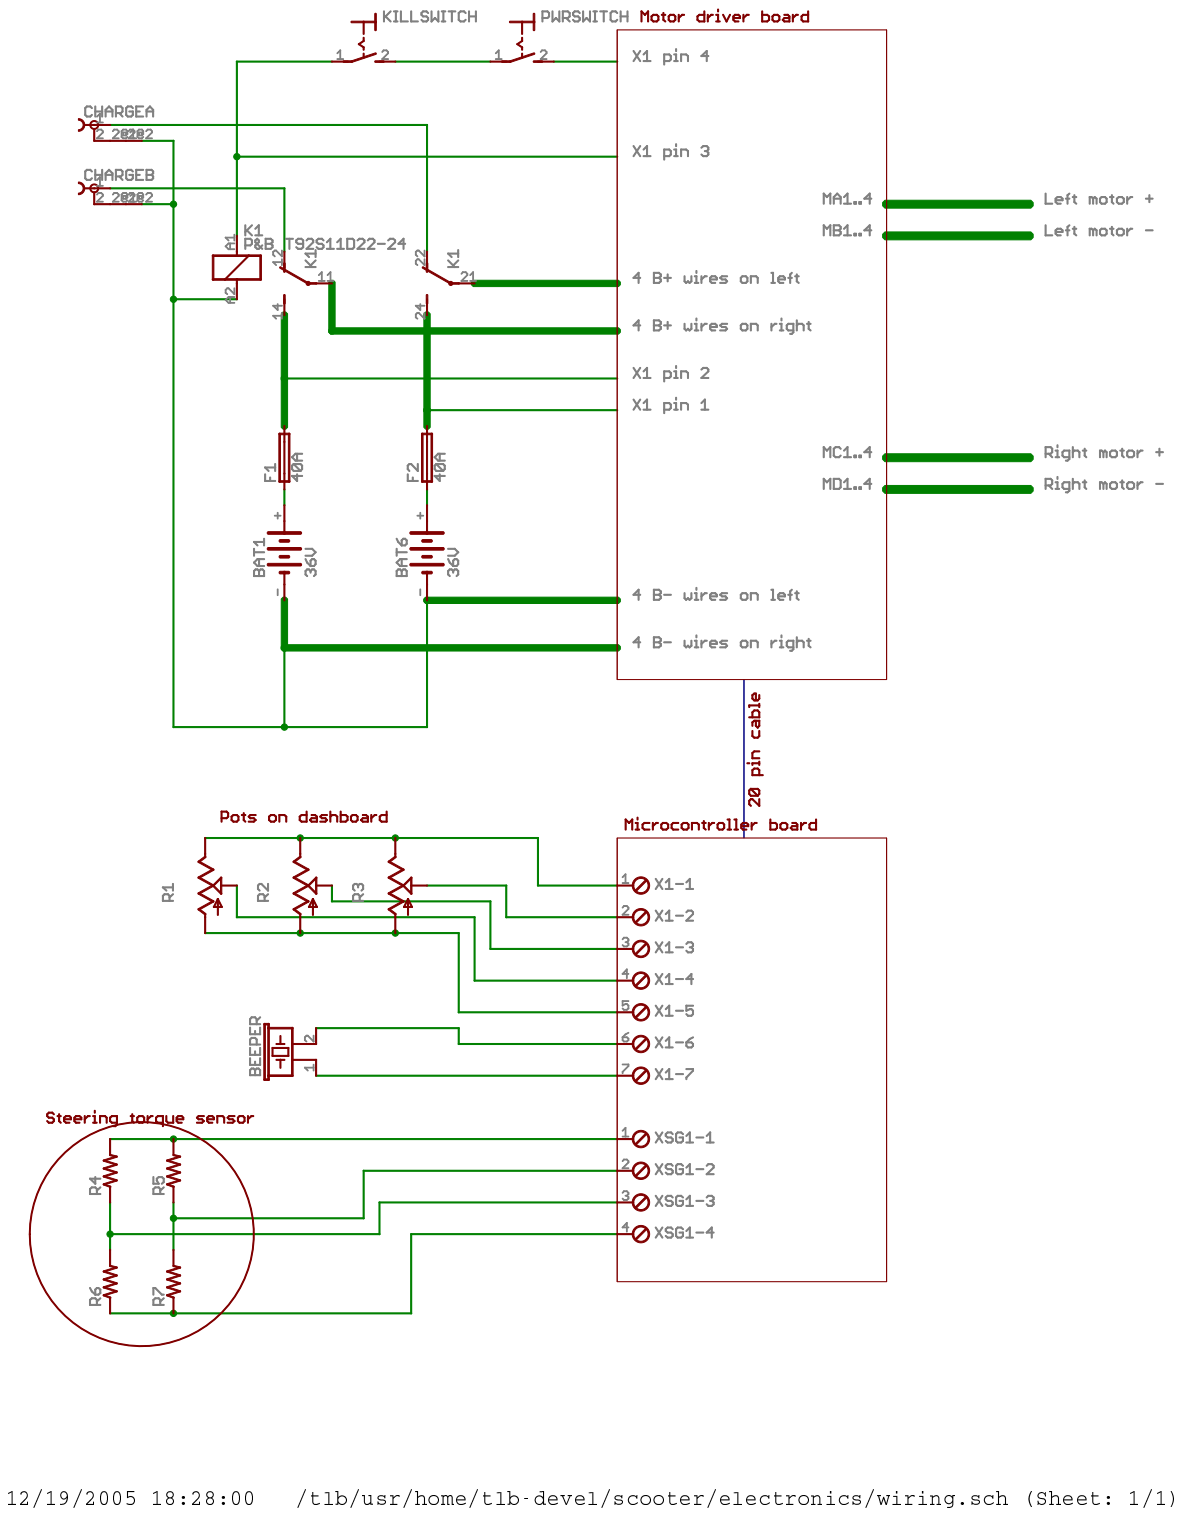
[picture p45: page 1]
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
