tlbtlbtlb/scooter/electronics/unicycle1/stuffdraw.pdf

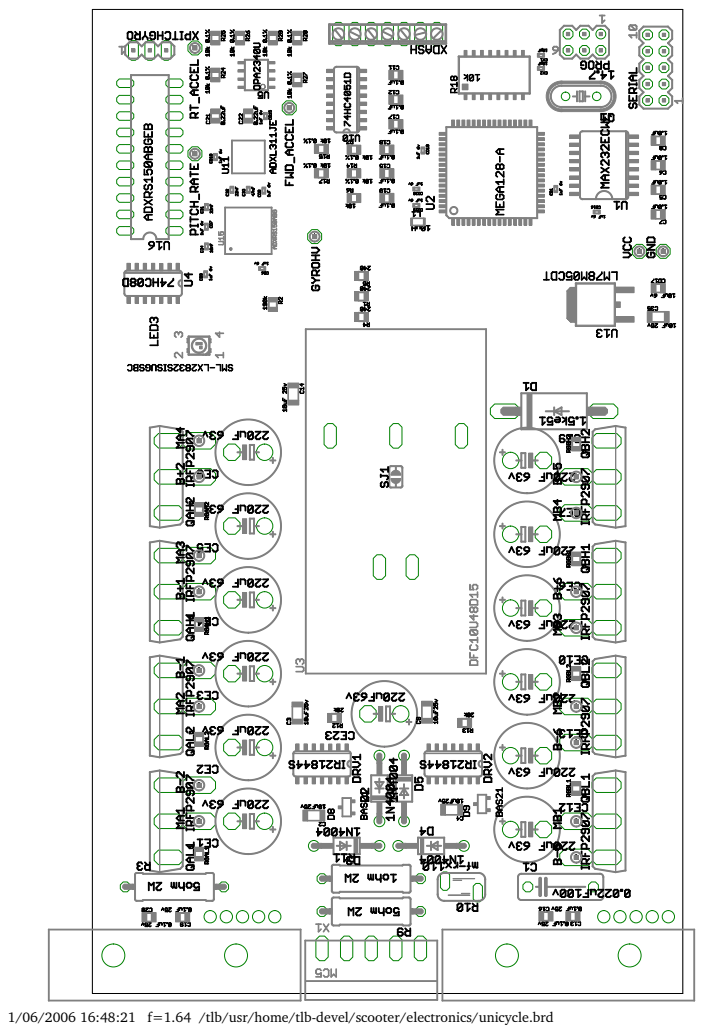
[picture p47: page 1]

1/06/2006 16:48:21 f=1.64 /tlb/usr/home/tlb-devel/scooter/electronics/unicycle.brd
