tlbtlbtlb/scooter/autopilot/onboard-release/pcb/autopilot_schematic.pdf

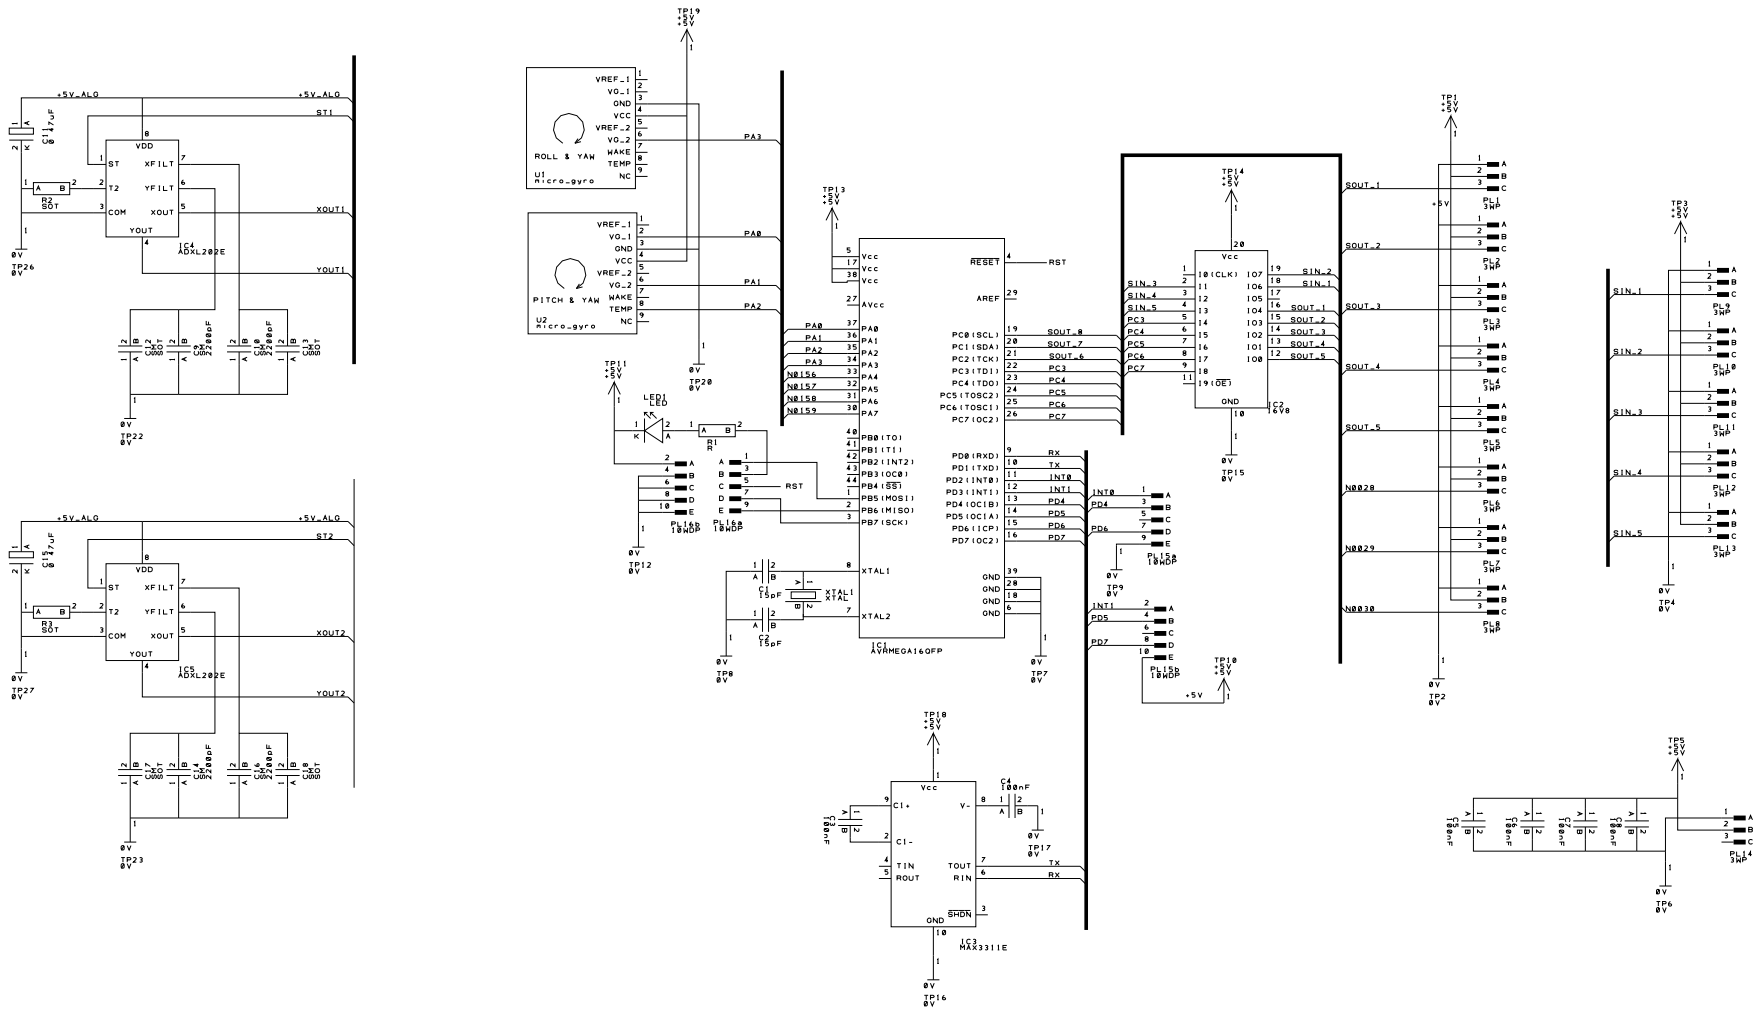
[picture p48: page 1]
