tlbtlbtlb/scooter/doc/osmc3-2 assy.pdf

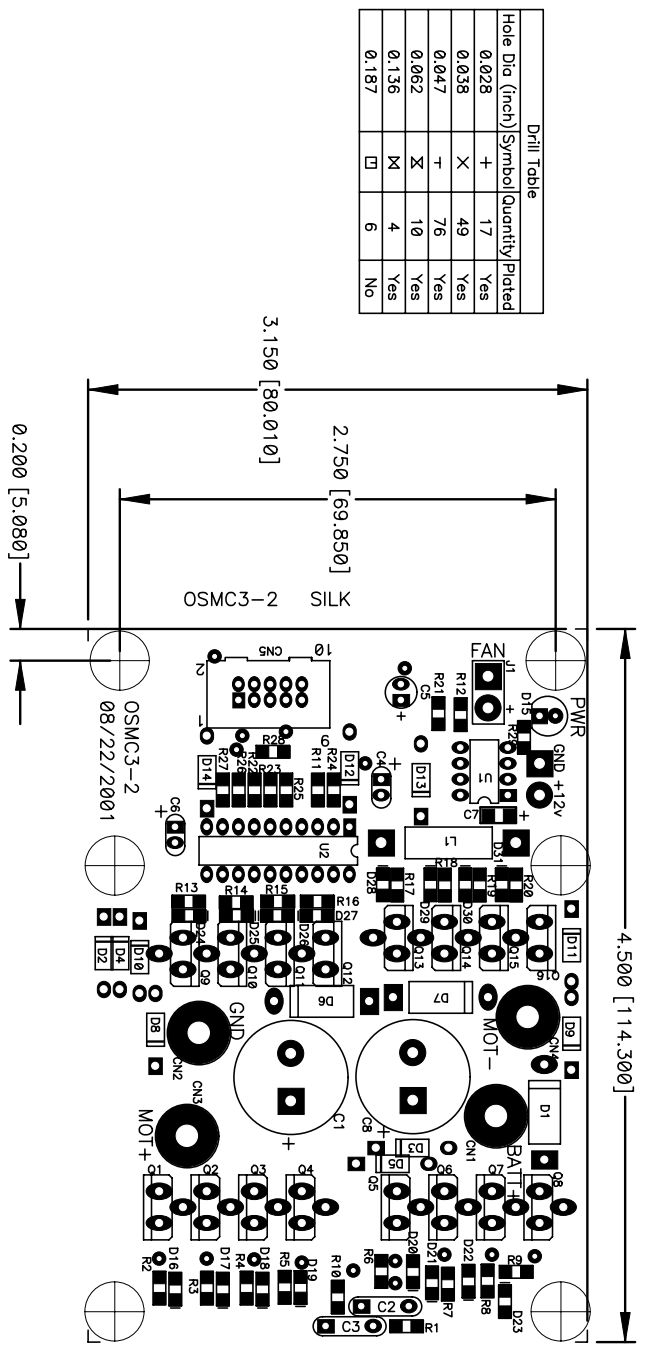
[picture p49: page 1]
