tlbtlbtlb/scooter/doc/osmc3-2 bott.pdf

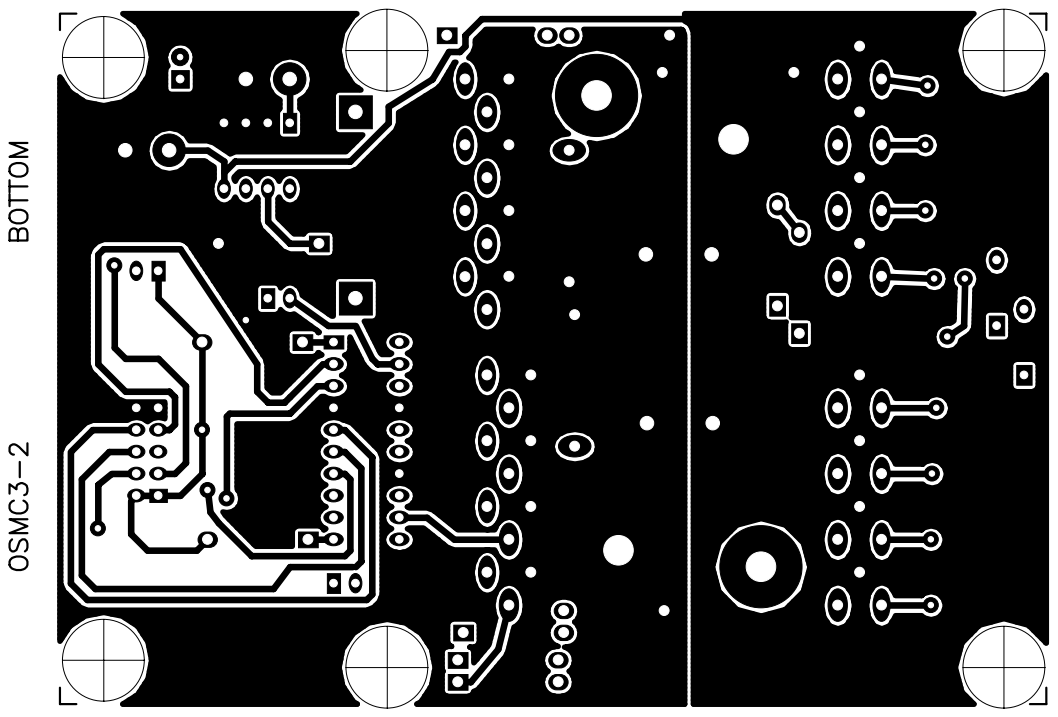
[picture p50: page 1]
