tlbtlbtlb/scooter/doc/osmc3-2 sch.pdf

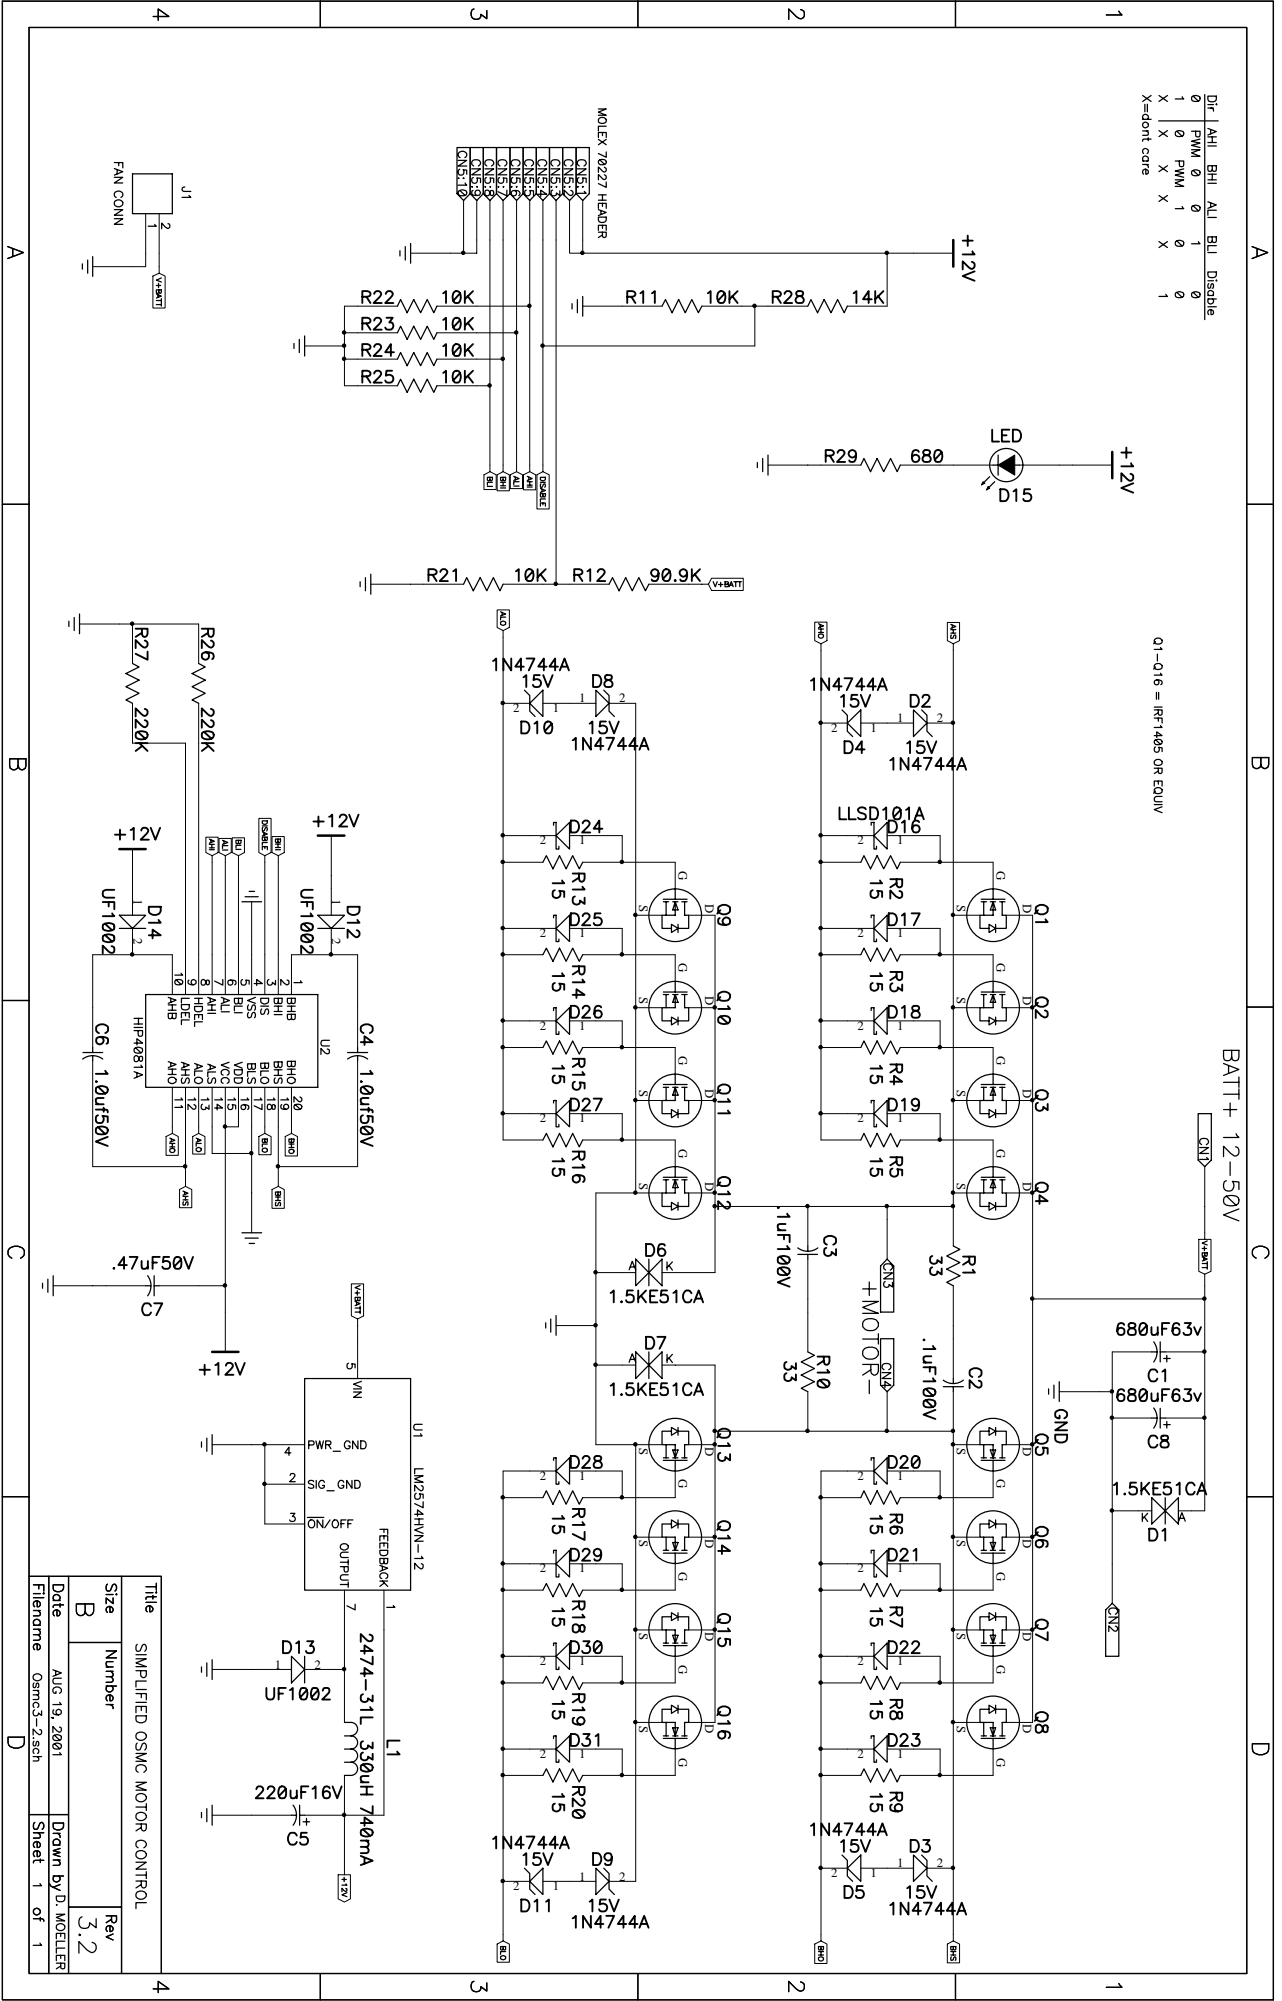
[picture p51: page 1]
