tlbtlbtlb/scooter/doc/osmc3-2 silk.pdf

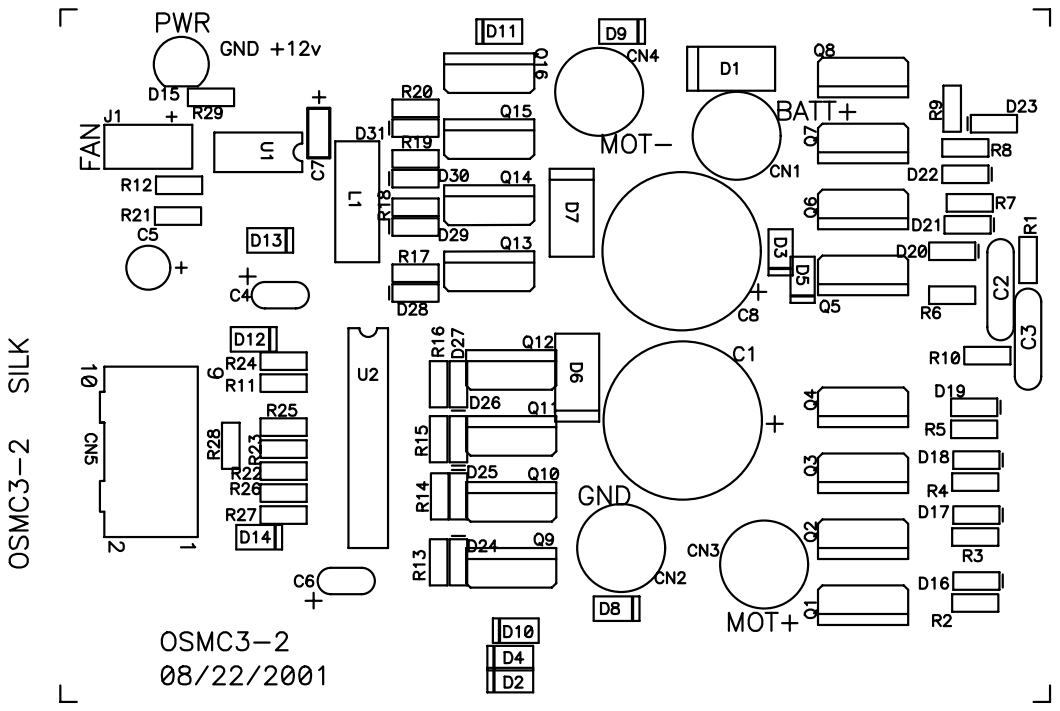
[picture p52: page 1]
