tlbtlbtlb/scooter/doc/osmc3-2 top.pdf

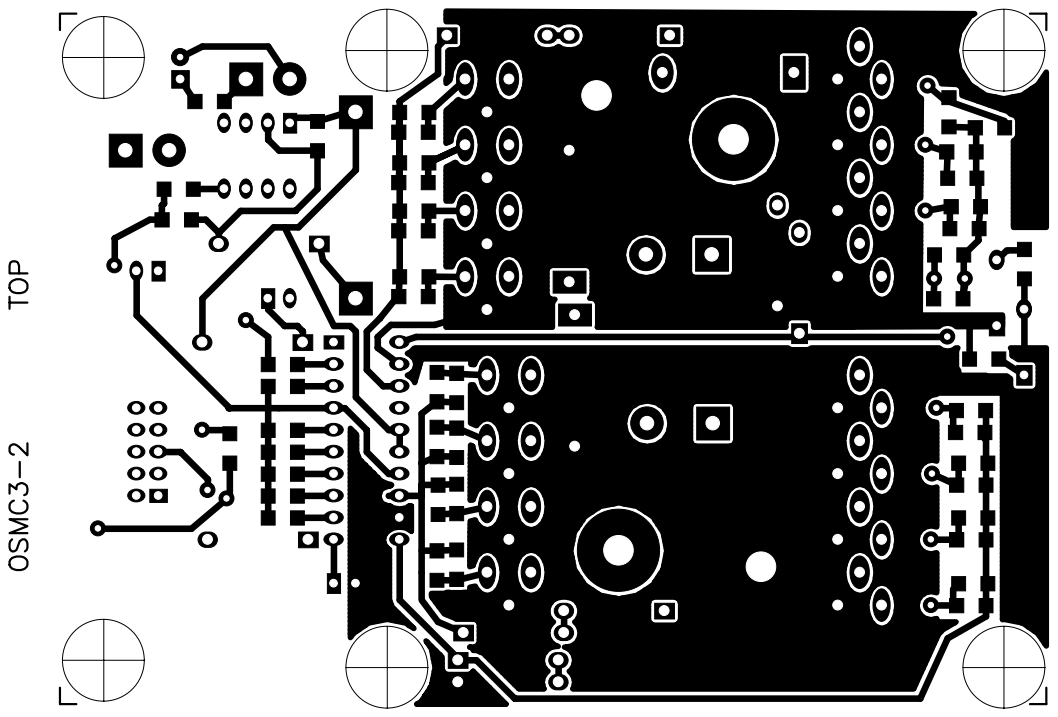
[picture p53: page 1]
