tlbtlbtlb/scooter/doc/rotoschsh1.pdf

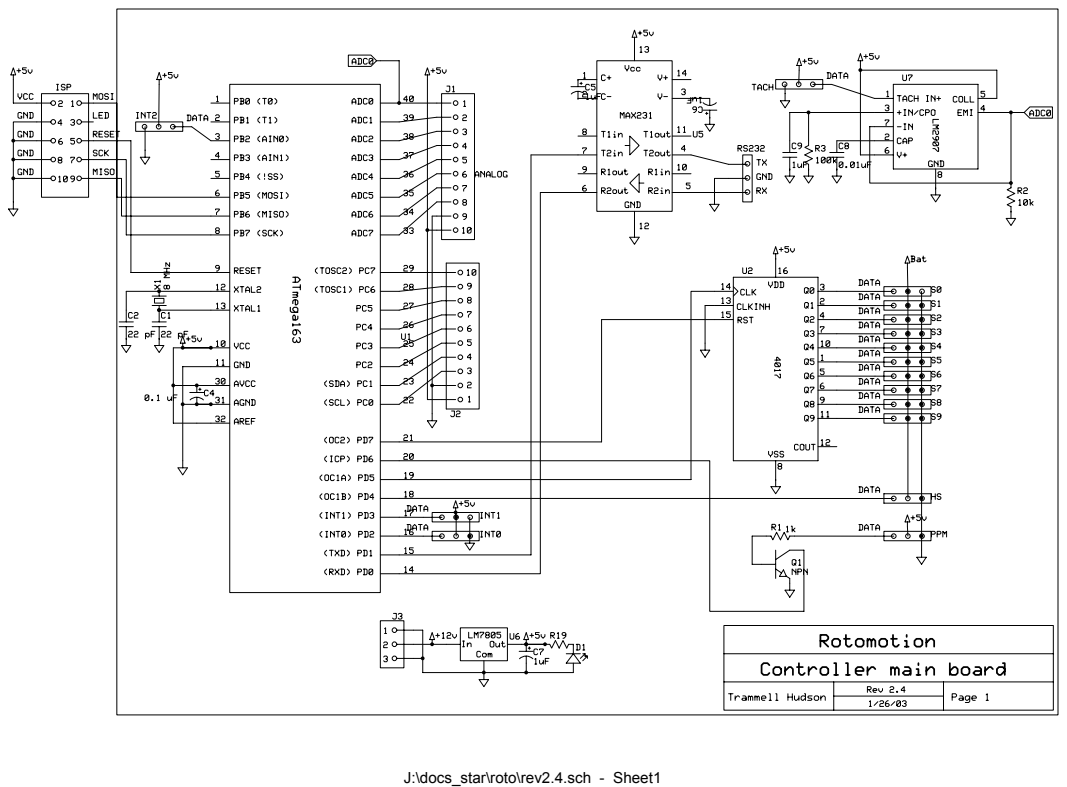
[picture p54: page 1]
J:\docs_star\roto\rev2.4.sch - Sheet1
