tlbtlbtlb/scooter/doc/rotoschsh2.pdf

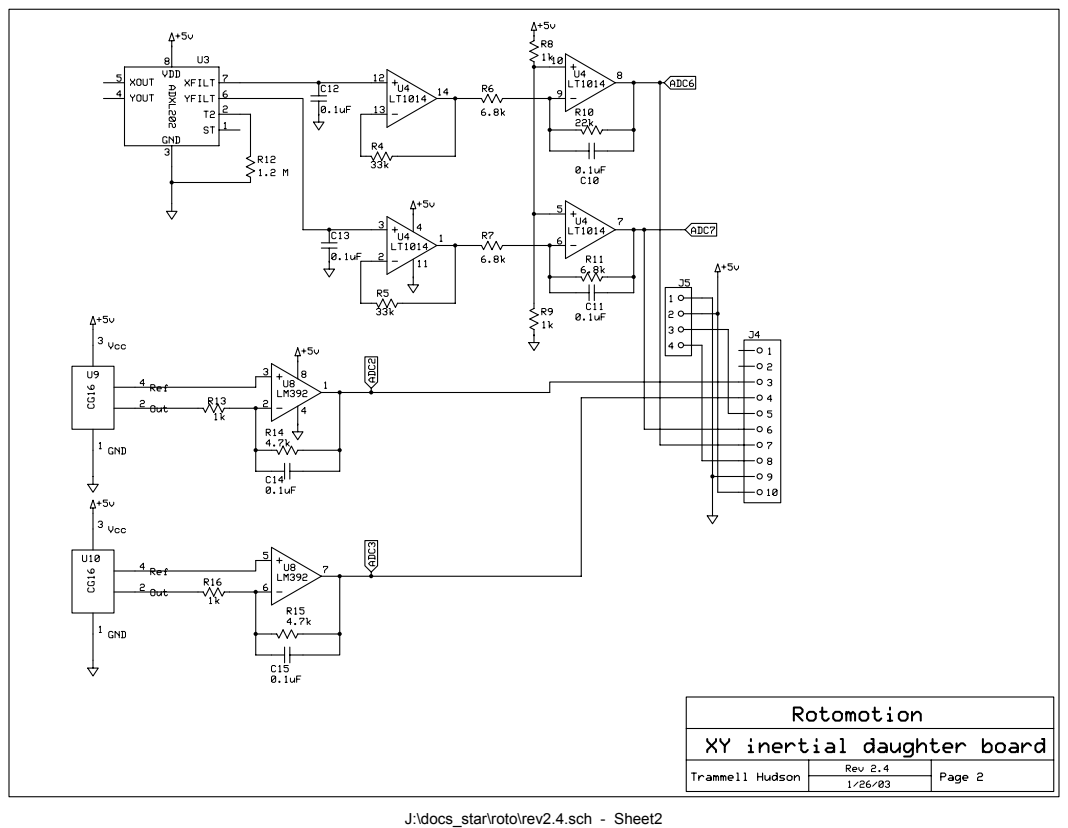
[picture p55: page 1]
J:\docs_star\roto\rev2.4.sch - Sheet2
