tlbtlbtlb/scooter/doc/rotoschsh3.pdf

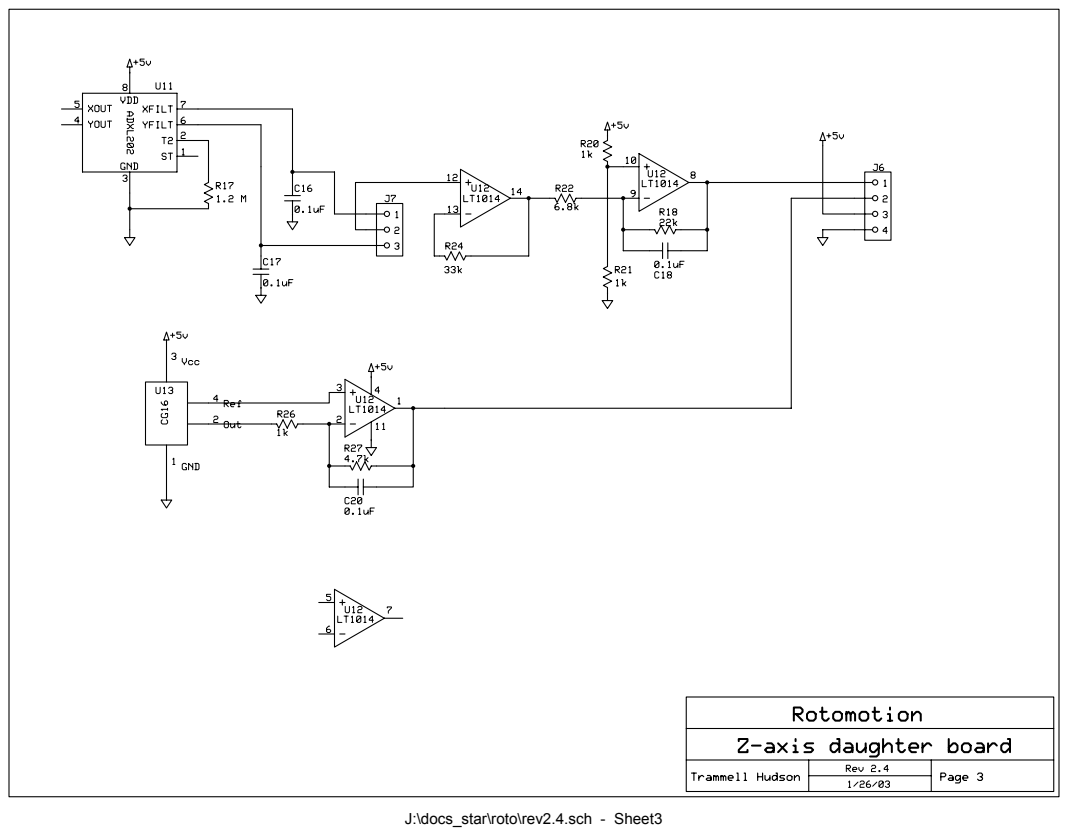
[picture p56: page 1]
J:\docs_star\roto\rev2.4.sch - Sheet3
